aramosfet/Boards/Eaglelibs/Seeed/EagleLib-of-Seeedstudio-master/readme

The Eagle Library for most of Seeed products is open to the customer. You can update the Seeed library or submit your own library as well. It should be under the license of CC BY-SA 3.0.

2011-6-01 14:00:41

Most recently updated on 2011/10/6
