aramosfet/Boards/SniperBoardv1-1/SniperBoard BOM.txt

Partlist exported from D:/Development/Boards/SniperBoardv1-1/SniperBoard.sch at 25/11/2017 12:58:10 PM

Part  Value                     Device                    Package                   Description                                                                         MF                      MPN                            OC_FARNELL OC_NEWARK PACKAGE PROD_ID     SUPPLIER           VALUE
BAT1  3V                        BATTERY20PTH              BATTCOM_20MM_PTH          Battery Holders                                                                                                                                                                                             
C1    100uF                     CAP_POLE                  PANASONIC_E               Capacitor Polarized                                                                                                                                                                                         
C2    470uF                     CAP_POLE                  PANASONIC_E               Capacitor Polarized                                                                                                                                                                                         
C3    0.1uF                     CAP0805                   0805                      Capacitor                                                                                                                                                                                                   
C4    470uF                     CAP_POLE                  PANASONIC_E               Capacitor Polarized                                                                                                                                                                                         
C5    10uF                      10UF-TANT                 EIA3216                   10uF Tantalum SMT                                                                                                                                                       CAP-00811                      10uF 
C6    0.1uF                     CAP0805                   0805                      Capacitor                                                                                                                                                                                                   
C7    0.1uF                     CAP0805                   0805                      Capacitor                                                                                                                                                                                                   
C8    0.1uF                     CAP0805                   0805                      Capacitor                                                                                                                                                                                                   
C9    0.1uF                     CAP0805                   0805                      Capacitor                                                                                                                                                                                                   
C10   0.1uF                     CAP0805                   0805                      Capacitor                                                                                                                                                                                                   
C11   20pF                      CAP0805                   0805                      Capacitor                                                                                                                                                                                                   
C12   20pF                      CAP0805                   0805                      Capacitor                                                                                                                                                                                                   
C13   27pF                      CAP0805                   0805                      Capacitor                                                                                                                                                                                                   
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
D6    1N4148WS-V-GS18           DIODESMA-ALT              SMA-DIODE_ALT             Diode                                                                                                                                                                                                       
D7    1N4148WS-V-GS18           DIODESMA-ALT              SMA-DIODE_ALT             Diode                                                                                                                                                                                                       
D8    1N5819                    DIODESMB                  SMB-DIODE                 Diode                                                                                                                                                                                                       
DC1                             NME                       NME                       DC-DC CONVERTER                                                                     C & D TECHNOLOGIES, INC NME1205D                       1021466    98B8198                                               
FID1  FIDUCIAL1.5X3             FIDUCIAL1.5X3             FIDUCIAL-1.5X3            Fiducial Alignment Points                                                                                                                                                                                   
FID2  FIDUCIAL1.5X3             FIDUCIAL1.5X3             FIDUCIAL-1.5X3            Fiducial Alignment Points                                                                                                                                                                                   
IC1   LDL117S33                 LD117ADT12TR              DPACK                     Low drop fixed and adjustable positive voltage regulators 1 A                                                                                                                                               
IC2   LM2596S                   LM2596S                   TO263-5                   SIMPLE SWITCHER® Power Converter 150 kHz 3A Step-Down Voltage Regulator             NATIONAL SEMICONDUCTOR  LM2596S-ADJ/NOPB               9494367    41K3842                                               
IC3   LD117AS50TR               LD117AS50TR               SOT223                    Low drop fixed and adjustable positive voltage regulators 1 A                                                                                                                                               
IC5   SI7006-A10-IM             SI7006-A10-IM             DFN6-3X3                  I2C Humidity and Temperature Sensor                                                 Silicon Labs            Si7006-A10-IM                  unknown    unknown                                               
J2                              RJ45-HR911105A-HR911105A  RJMG1BD3B8K1ANR                                                                                                                                                                                                                       
J4                              RJ45-HR911105A-HR911105A  RJMG1BD3B8K1ANR                                                                                                                                                                                                                       
JP1                             M03PTH                    1X03                      Header 3                                                                                                                                                                                                    
JP2                             M03POLAR                  MOLEX-1X3                 Header 3                                                                                                                                                                                                    
JP3   USB-B                     USBPTH                    USB-B-PTH                 USB Connectors                                                                                                                                                          CONN-08278                     USB-B
JP4                             M03PTH                    1X03                      Header 3                                                                                                                                                                                                    
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
T2    MOSFET-NCHANNELBSS123LT1G MOSFET-NCHANNELBSS123LT1G SOT23                     Common NMOSFET Parts                                                                                                                                                    TRANS-08345                         
T3    MOSFET-NCHANNELBSS123LT1G MOSFET-NCHANNELBSS123LT1G SOT23                     Common NMOSFET Parts                                                                                                                                                    TRANS-08345                         
T4    MOSFET-NCHANNELBSS123LT1G MOSFET-NCHANNELBSS123LT1G SOT23                     Common NMOSFET Parts                                                                                                                                                    TRANS-08345                         
U$1   ENC424J600                ENC424J600                TQFP-44                   MICROCHIP ENC424J600                                                                                                                                                                                        
U$2   1X02_TERMB_RA             1X02_TERMB_RA             1X02_TERMB_RA                                                                                                                                                                                                                         
U$3   ENC424J600                ENC424J600                TQFP-44                   MICROCHIP ENC424J600                                                                                                                                                                                        
U$4   NC7SP157                  NC7SP157                  SC70-6                                                                                                                                                                                                                                
U$5   STM32F030K6T6             STM32F030K6T6             LQFP32-7X7                                                                                                                                                                                                                            
U1    MAX485                    MAX485                    SOP8                                                                                                                                                                                                                                  
U2    STM32F103CBT6             STM32F103CBT6             QFP50P900X900X160-48N     Medium-density performance line ARM-based 32-bit MCU                                                        STM32F103CBT6                  1606327    11N8296   QFP-48              STMICROELECTRONICS      
U3    MC34063SMD                MC34063SMD                SO08                      Jellybean switching supply controller                                                                                                                                                                       
U4    ST232CDR                  ST232CDR                  SOIC127P600X175-16N       5 V powered multi-channel RS-232 drivers and receivers                                                      ST232CDR                       1564303    89K0993   SOIC-16             STMICROELECTRONICS      
U5    S25FL004K0XMFI040         S25FL004K0XMFI040         SOIC127P600X175-8N        4-Mbit CMOS 3.0 Volt Flash Memory                                                                           S25FL004K0XMFI040              -          22T5467   SOIC-8              SPANSION                
U6    LCD-16X2SILK              LCD-16X2SILK              LCD-16X2                  Standard text-only 16x2 parallel input LCD                                                                                                                                                                  
X1                              DB9FEMALE                 DB9                       DB9 Connector                                                                                                                                                                                               
Y1    32.768Khz                 MC-306                    MC-306                    kHz RANGE CRYSTAL UNIT SMD                                                                                  MC-306 60.0KHZ  100PPM ,12.5PF 1278040    31M5576                                               
Y2    8Mhz                      CRYSTALHC49US             HC49US                    Various standard crystals. Proven footprints. Spark Fun Electronics SKU : COM-00534                                                                                                                         
Y3    25Mhz                     CRYSTAL10.5X4.8           CRYSTAL-SMD-10.5X4.8-2PIN Various standard crystals. Proven footprints. Spark Fun Electronics SKU : COM-00534                                                                                                                         
Y4    25Mhz                     CRYSTAL10.5X4.8           CRYSTAL-SMD-10.5X4.8-2PIN Various standard crystals. Proven footprints. Spark Fun Electronics SKU : COM-00534
