aramosfet/Boards/SniperBoardv1-1/SniperBoard BOM.xls

Sheet: SniperBoard
Qty | Purchase Qty | Value | Device | Source | Package | Parts | Description
1 | 8 |  | DB9FEMALE | SP Road | DB9 Femail PCB Right Angle | X1 | DB9 Connector
8 | 65 |  | M025MM | SP Road | SCREWTERMINAL-5MM-2 | JP10, JP13, JP14, JP15, JP16, JP17, JP18, JP19 | Header 2
3 | 2 |  | M02PTH | SP Road | Berg stick | JP6, JP8, JP9 | Header 2
5 | 45 |  | M03-SCREW-5MM | SP Road | SCREWTERMINAL-5MM-3 | JP20, JP21, JP22, JP23, JP24,JP4, JP7 | Header 3
2 | 15 |  | M03POLAR | SP Road | Relimate 3 pin | JP2, JP25 | Header 3
2 | 15 |  | M02POLAR | SP Road | Relimate 2 pin
1 |  |  | CRE505S | Digikey | NME | DC1 | DC-DC CONVERTER
2 |  |  | RJ45-HR911105A-HR911105A | Digikey | RJMG1BD3B8K1ANR | J2, J4
3 | 30 |  | TAC_SWITCHPTH | SP Road | TACTILE-PTH | S1, S2, S5 | Momentary Switch
2 | 100 | 0R | RESISTOR0805-RES | SP Road | 0805 | R59, R60 | Resistor
8 | 100 | 0.01uF | CAP0805 | SP Road | 0805 | C29, C30, C31, C32, C41, C42, C43, C44 | Capacitor
27 | 200 | 0.1uF | CAP0805 | SP Road | 0805 | C3, C6, C7, C8, C9, C10, C18, C19, C20, C21, C22, C23, C27, C28, C33, C34, C35, C38, C39, C45, C46, C47, C48, C49, C50, C51, C52 | Capacitor
1 |  | 0.68R | RESISTOR0805-RES | Digikey | 805 | R7 | Resistor
2 | 100 | 1.5K | RESISTOR0805-RES | SP Road | 0805 | R9, R45 | Resistor
4 | 100 | 100K | RESISTOR0805-RES | SP Road | 0805 | R11, R20, R47, R48 | Resistor
2 |  | 100uF | CAP_POLE | Digikey | PANASONIC_E | C1, C15 | Capacitor Polarized
6 | 100 | 10K | RESISTOR0805-RES | SP Road | 0805 | R4, R28, R29, R43, R56, R57 | Resistor
1 | 100 | 120R | RESISTOR1206 | SP Road | 1206 | R58 | Resistor
2 | 100 | 10R | RESISTOR0805-RES | SP Road | 0805 | R16, R25 | Resistor
2 | 40 | 10uF | 10UF-TANT | SP Road | CASE B | C5, C16,C26, C40 | 10uF Tantalum SMT
3 |  | 10uH | INDUCTOR0805 | Digikey | 805 | L2, L4, L5 | Inductors
2 |  | 12.4K | RESISTOR0805-RES | Digikey | 805 | R10, R19 | Resistor
1 |  | 13K | RESISTOR0805-RES | Digikey | 805 | R8 | Resistor
1 | 100 | 1K | RESISTOR0805-RES | SP Road | 0805 | R1 | Resistor
4 | 40 | 1N4148WS-V-GS18 | DIODESMA-ALT | SP Road | SOD | D2, D3, D6, D7 | Diode
1 | 10 | 1N5819 | DIODESMB | SP Road | SMB-DIODE | D8 | Diode
1 | 10 | 1X02_TERMB_RA | 1X02_TERMB_RA | SP Road | 1X02_TERMB_RA Pluggable | U$2
1 | 100 | 2.2K | RESISTOR0805-RES | SP Road | 0805 | R2 | Resistor
2 | 100 | 20pF | CAP0805 | SP Road | 0805 | C11, C12 | Capacitor
1 | 100 | 220pF | CAP0805 | SP Road | 0805 | C17 | Capacitor
2 |  | 220uH | INDUCTORRADIAL5MM | Digikey | RLB914-IND | L1, L3 | Inductors
2 | 100 | 22R | RESISTOR0805-RES | SP Road | 0805 | R5, R6 | Resistor
2 |  | 25Mhz | CRYSTAL10.5X4.8 | Digikey | CRYSTAL-SMD-10.5X4.8-2PIN | Y3, Y4 | Various standard crystals. Proven footprints. Spark Fun Electronics SKU : COM-00534
6 | 100 | 27pF | CAP0805 | SP Road | 0805 | C13, C14, C24, C25, C36, C37 | Capacitor
1 |  | 32.768Khz | MC-306 | Digikey | MC-306 | Y1 | kHz RANGE CRYSTAL UNIT SMD
1 | 10 | 3V | BATTERY20PTH | SP Road | CR2032 Holder+Battery | BAT1 | Battery Holders
25 | 200 | 470R | RESISTOR0805-RES | SP Road | 0805 | R3, R17, R18, R26, R27, R31, R32, R33, R34, R35, R36, R37, R38, R39, R40, R41, R42, R44, R49, R50, R51, R52, R53, R54, R55 | Resistor
2 |  | 470uF | CAP_POLE | Digikey | PANASONIC_E | C2, C4 | Capacitor Polarized
8 |  | 49.9R | RESISTOR0805-RES | Digikey | 805 | R12, R13, R14, R15, R21, R22, R23, R24 | Resistor
25 | 200 | 330R | RESISTOR0805-RES | SP Road | 0805 | R3, R17, R18, R26, R27, R31, R32, R33, R34, R35, R36, R37, R38, R39, R40, R41, R42, R44, R49, R50, R51, R52, R53, R54, R55 | Resistor
1 | 10 | 8Mhz | CRYSTALHC49US | SP Road | HC49US half size TH | Y2 | Various standard crystals. Proven footprints. Spark Fun Electronics SKU : COM-00534
1 |  | BAS40-05 | BAS40-05 | Digikey | SOT23 | D5 | Silicon Schottky Diodes
2 |  | ENC424J600 | ENC424J600 | Digikey | TQFP-44 | U$1, U$3 | MICROCHIP ENC424J600
13 | 120 | Green | LED1206 | SP Road | LED-1206 | LED1, LED2, LED3, LED4, LED5, LED6, LED7, LED8, LED9, LED10, LED11, LED12, LED13 | LEDs
1 |  | LCD-16X2SILK | LCD-16X2SILK | SP Road | LCD-16X2 | U6 | Standard text-only 16x2 parallel input LCD
1 | 10 | LD117AS50TR (AMS1117-5.0) | LD117AS50TR | SP Road | SOT223 | IC3 | Low drop fixed and adjustable positive voltage regulators 1 A
1 |  | LDL117S33 | LD117ADT12TR | Digikey | DPACK | IC1 | Low drop fixed and adjustable positive voltage regulators 1 A
1 |  | LM2596S | LM2596S | Digikey | TO263-5 | IC2 | SIMPLE SWITCHER® Power Converter 150 kHz 3A Step-Down Voltage Regulator
1 | 10 | M05X2SHD 10 pin Header | M05X2SHD | SP Road | 2X5-SHROUDED | JP12 | Header 5x2
1 | 10 | MAX485 /SP3485 Eq | MAX485 | SP Road | SOP8 | U1
1 | 10 | MC34063SMD | MC34063SMD | SP Road | SO08 | U3 | Jellybean switching supply controller
4 | 40 | 2N7002 -BSS123LT1G | MOSFET-NCHANNELBSS123LT1G | SP Road | SOT23 | T1, T2, T3, T4 | Common NMOSFET Parts
1 |  | NC7SP157 | NC7SP157 | Digikey | SC70-6 | U$4
8 | 65 | PC817 | PC817 | SP Road | DIL04 | OK1, OK2, OK3, OK4, OK5, OK6, OK7, OK8 | SHARP OPTO COUPLER
1 |  | S25FL004K0XMFI040 | S25FL004K0XMFI040 | Digikey | SOIC127P600X175-8N | U5 | 4-Mbit CMOS 3.0 Volt Flash Memory
1 |  | SI7006-A10-IM | SI7006-A10-IM | Digikey | DFN6-3X3 | IC5 | I2C Humidity and Temperature Sensor
2 | 20 | SK34 | DIODESMA | SP Road | SMA-DIODE | D1, D4 | Diode
1 | 10 | ST3232CDR | ST232CDR | SP Road | SOIC127P600X175-16N | U4 | 5 V powered multi-channel RS-232 drivers and receivers
1 |  | STM32F030K6T6 | STM32F030K6T6 | Digikey | LQFP32-7X7 | U$5
1 |  | STM32F103CBT6 | STM32F103CBT6 | Digikey | QFP50P900X900X160-48N | U2 | Medium-density performance line ARM-based 32-bit MCU
1 | 10 | TRIMPOT 10K | TRIMPOTPTH | SP Road | TRIM_POT_PTH | R30 | Various small potentiometers for set-and-forget" applications"
1 | 10 | USB-B | USBPTH | SP Road | USB-B-PTH | JP3 | USB Connectors
4 | 40 | ZF112 | ZF112 | SP Road | ZF112 | K1, K2, K3, K4 | RELAY

Sheet: Sheet1
Qty | Value | Device | Package | Price | Cost
8 |  | DB9FEMALE | DB9 Femail PCB Right Angle | 10 | 80
65 |  | M025MM | SCREWTERMINAL-5MM-2 | 3 | 195
2 |  | M02PTH | Berg stick | 10 | 20
45 |  | M03-SCREW-5MM | SCREWTERMINAL-5MM-3 | 4.5 | 202.5
15 |  | M03POLAR | Relimate 3 pin | 4 | 60
15 |  | M02POLAR | Relimate 2 pin | 6 | 90
30 |  | TAC_SWITCHPTH | TACTILE-PTH | 5 | 150
100 | 0R | RESISTOR0805-RES | 0805 | 0.2 | 20
100 | 0.01uF | CAP0805 | 0805 | 0.5 | 50
200 | 0.1uF | CAP0805 | 0805 | 0.5 | 100
100 | 1.5K | RESISTOR0805-RES | 0805 | 0.2 | 20
100 | 100K | RESISTOR0805-RES | 0805 | 0.2 | 20
100 | 10K | RESISTOR0805-RES | 0805 | 0.2 | 20
100 | 120R | RESISTOR1206 | 1206 | 0.2 | 20
100 | 10R | RESISTOR0805-RES | 0805 | 0.2 | 20
40 | 10uF | 10UF-TANT | CASE B | 6 | 240
100 | 1K | RESISTOR0805-RES | 0805 | 0.2 | 20
40 | 1N4148WS-V-GS18 | DIODESMA-ALT | SOD | 1 | 40
10 | 1N5819 | DIODESMB | SMB-DIODE | 4 | 40
10 | 1X02_TERMB_RA | 1X02_TERMB_RA | 1X02_TERMB_RA Pluggable | 10 | 100
100 | 2.2K | RESISTOR0805-RES | 0805 | 0.2 | 20
100 | 20pF | CAP0805 | 0805 | 0.5 | 50
100 | 220pF | CAP0805 | 0805 | 0.5 | 50
100 | 22R | RESISTOR0805-RES | 0805 | 0.2 | 20
100 | 27pF | CAP0805 | 0805 | 0.5 | 50
10 | 3V | BATTERY20PTH | CR2032 Holder+Battery | 15 | 150
200 | 470R | RESISTOR0805-RES | 0805 | 0.2 | 40
200 | 330R | RESISTOR0805-RES | 0805 | 0.2 | 40
10 | 8Mhz | CRYSTALHC49US | HC49US half size TH | 8 | 80
140 | Green | LED1206 | LED-1206 | 2 | 280
 | LCD-16X2SILK | LCD-16X2SILK | LCD-16X2 |  | 0
10 | LD117AS50TR (AMS1117-5.0) | LD117AS50TR | SOT223 | 8 | 80
10 | M05X2SHD 10 pin Header | M05X2SHD | 2X5-SHROUDED | 5 | 50
10 | MAX485 /SP3485 Eq | MAX485 | SOP8 | 110 | 1100
10 | MC34063SMD | MC34063SMD | SO08 | 10 | 100
40 | 2N7002 -BSS123LT1G | MOSFET-NCHANNELBSS123LT1G | SOT23 | 6 | 240
65 | PC817 | PC817 | DIL04 | 10 | 650
20 | SK34 | DIODESMA | SMA-DIODE | 10 | 200
6 | ST3232CDR | ST232CDR | SOIC127P600X175-16N | 25 | 150
10 | TRIMPOT 10K | TRIMPOTPTH | TRIM_POT_PTH | 2 | 20
10 | USB-B | USBPTH | USB-B-PTH | 12 | 120
24 | ZF112 | ZF112 | ZF112 | 30 | 720
1 | Kapton tape |  |  | 250 | 250
 |  |  |  |  | 5967.5
