aramosfet/Boards/SniperBoard/SniperBoard Schematics.pdf

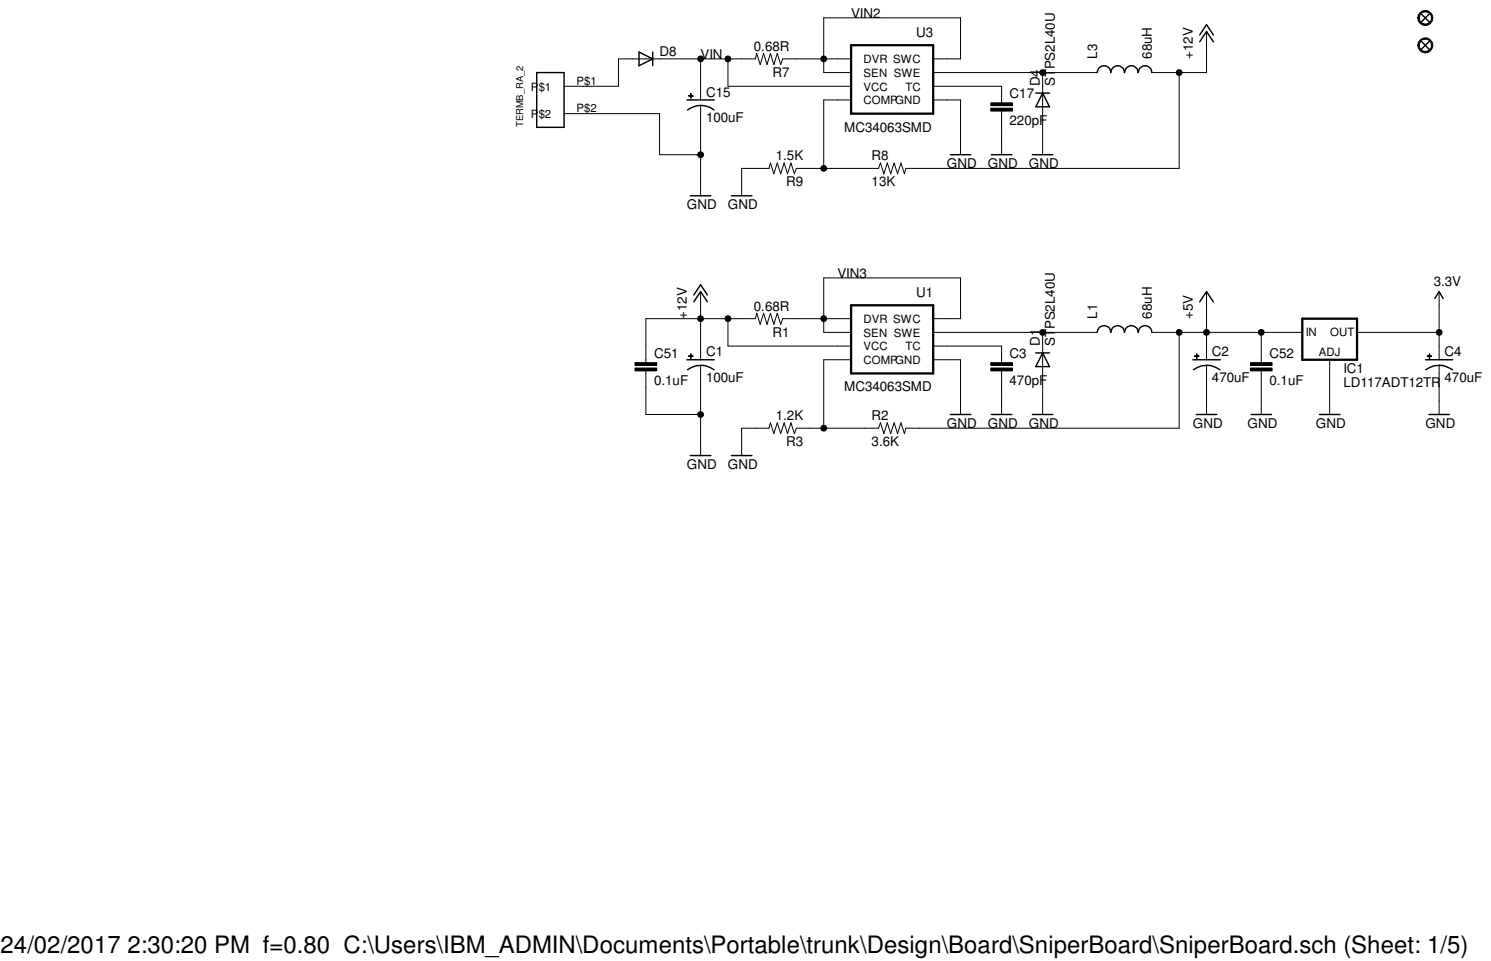
[picture p1: page 1]

24/02/2017 2:30:20 PM f=0.80 C:\Users\IBM_ADMIN\Documents\Portable\trunk\Design\Board\SniperBoard\SniperBoard.sch (Sheet: 1/5)

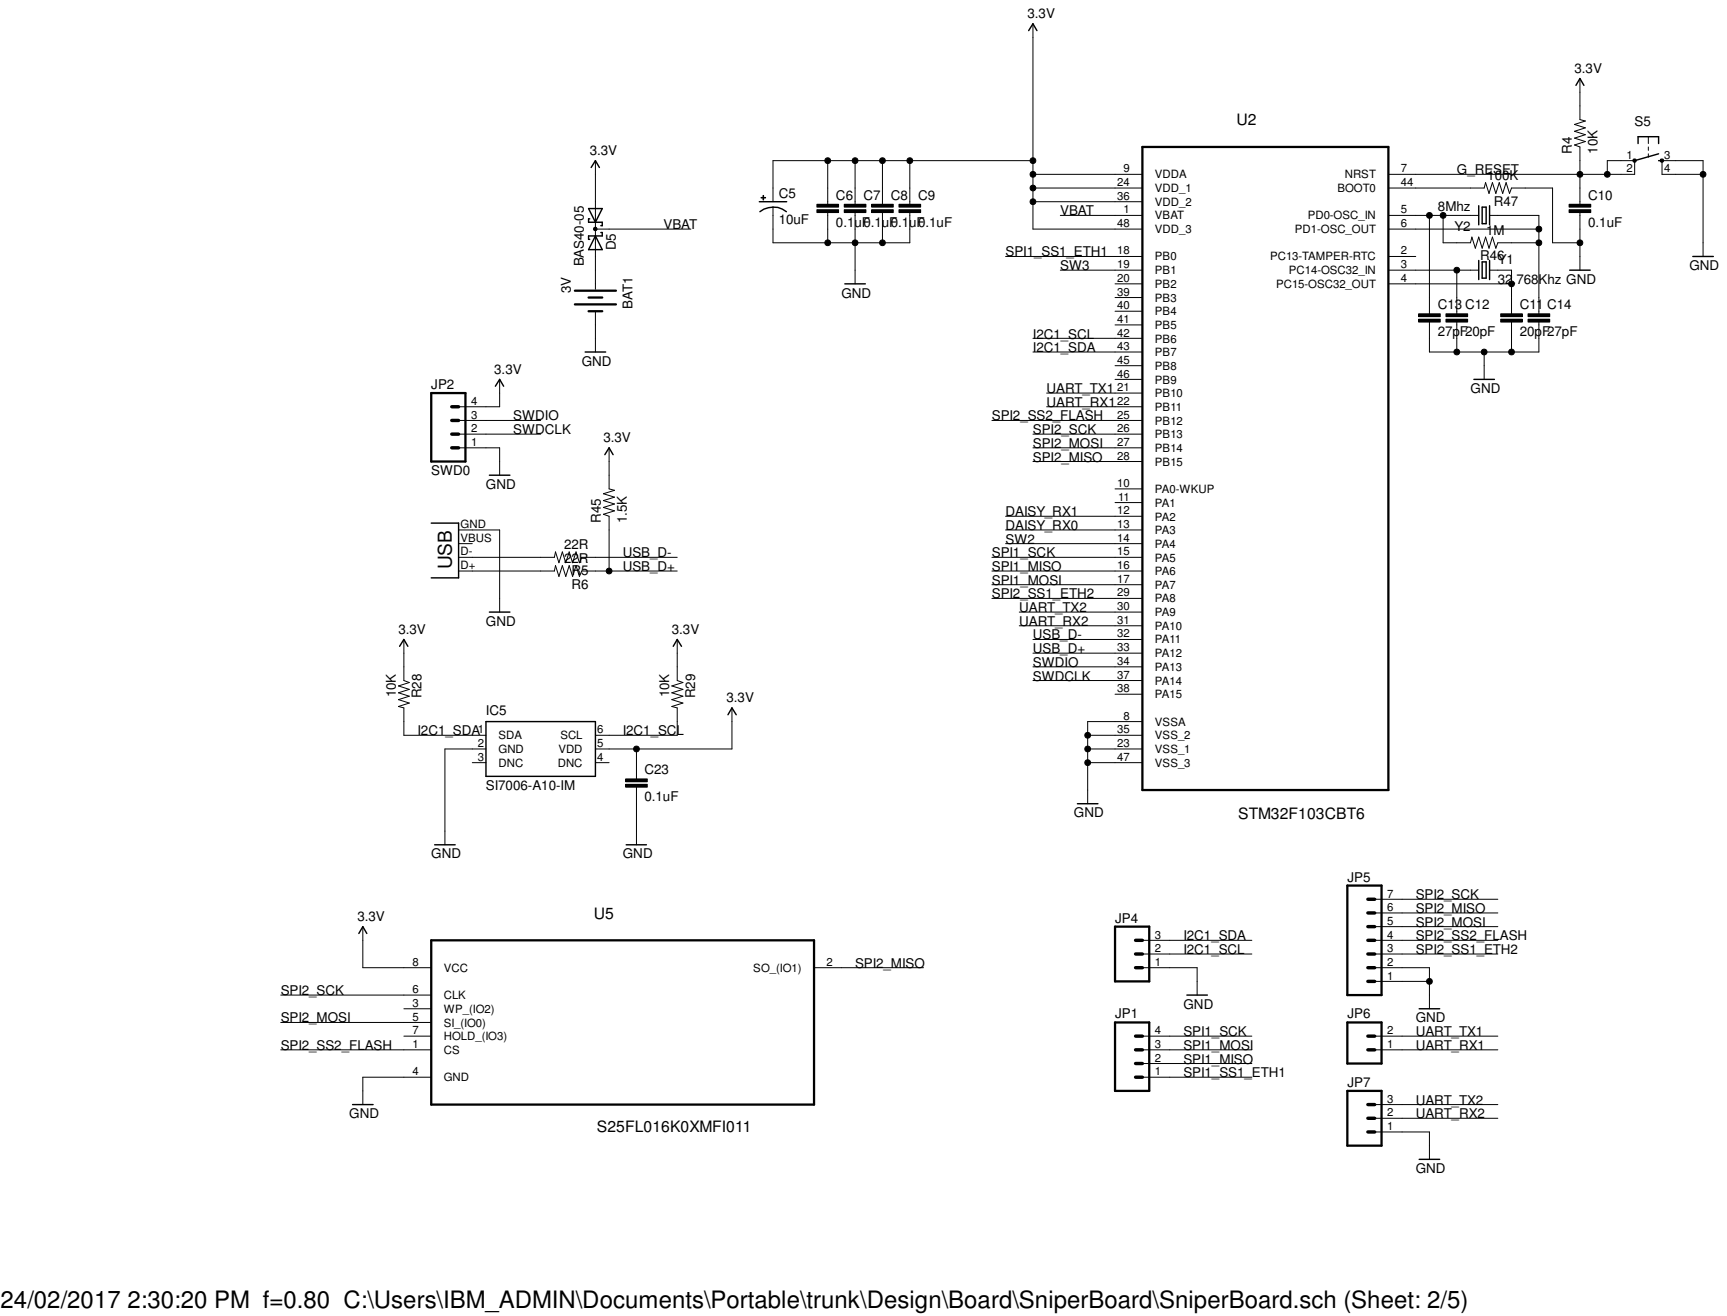
[picture p2: page 2]

24/02/2017 2:30:20 PM f=0.80 C:\Users\IBM_ADMIN\Documents\Portable\trunk\Design\Board\SniperBoard\SniperBoard.sch (Sheet: 2/5)

# GND TRIMPOT 10K

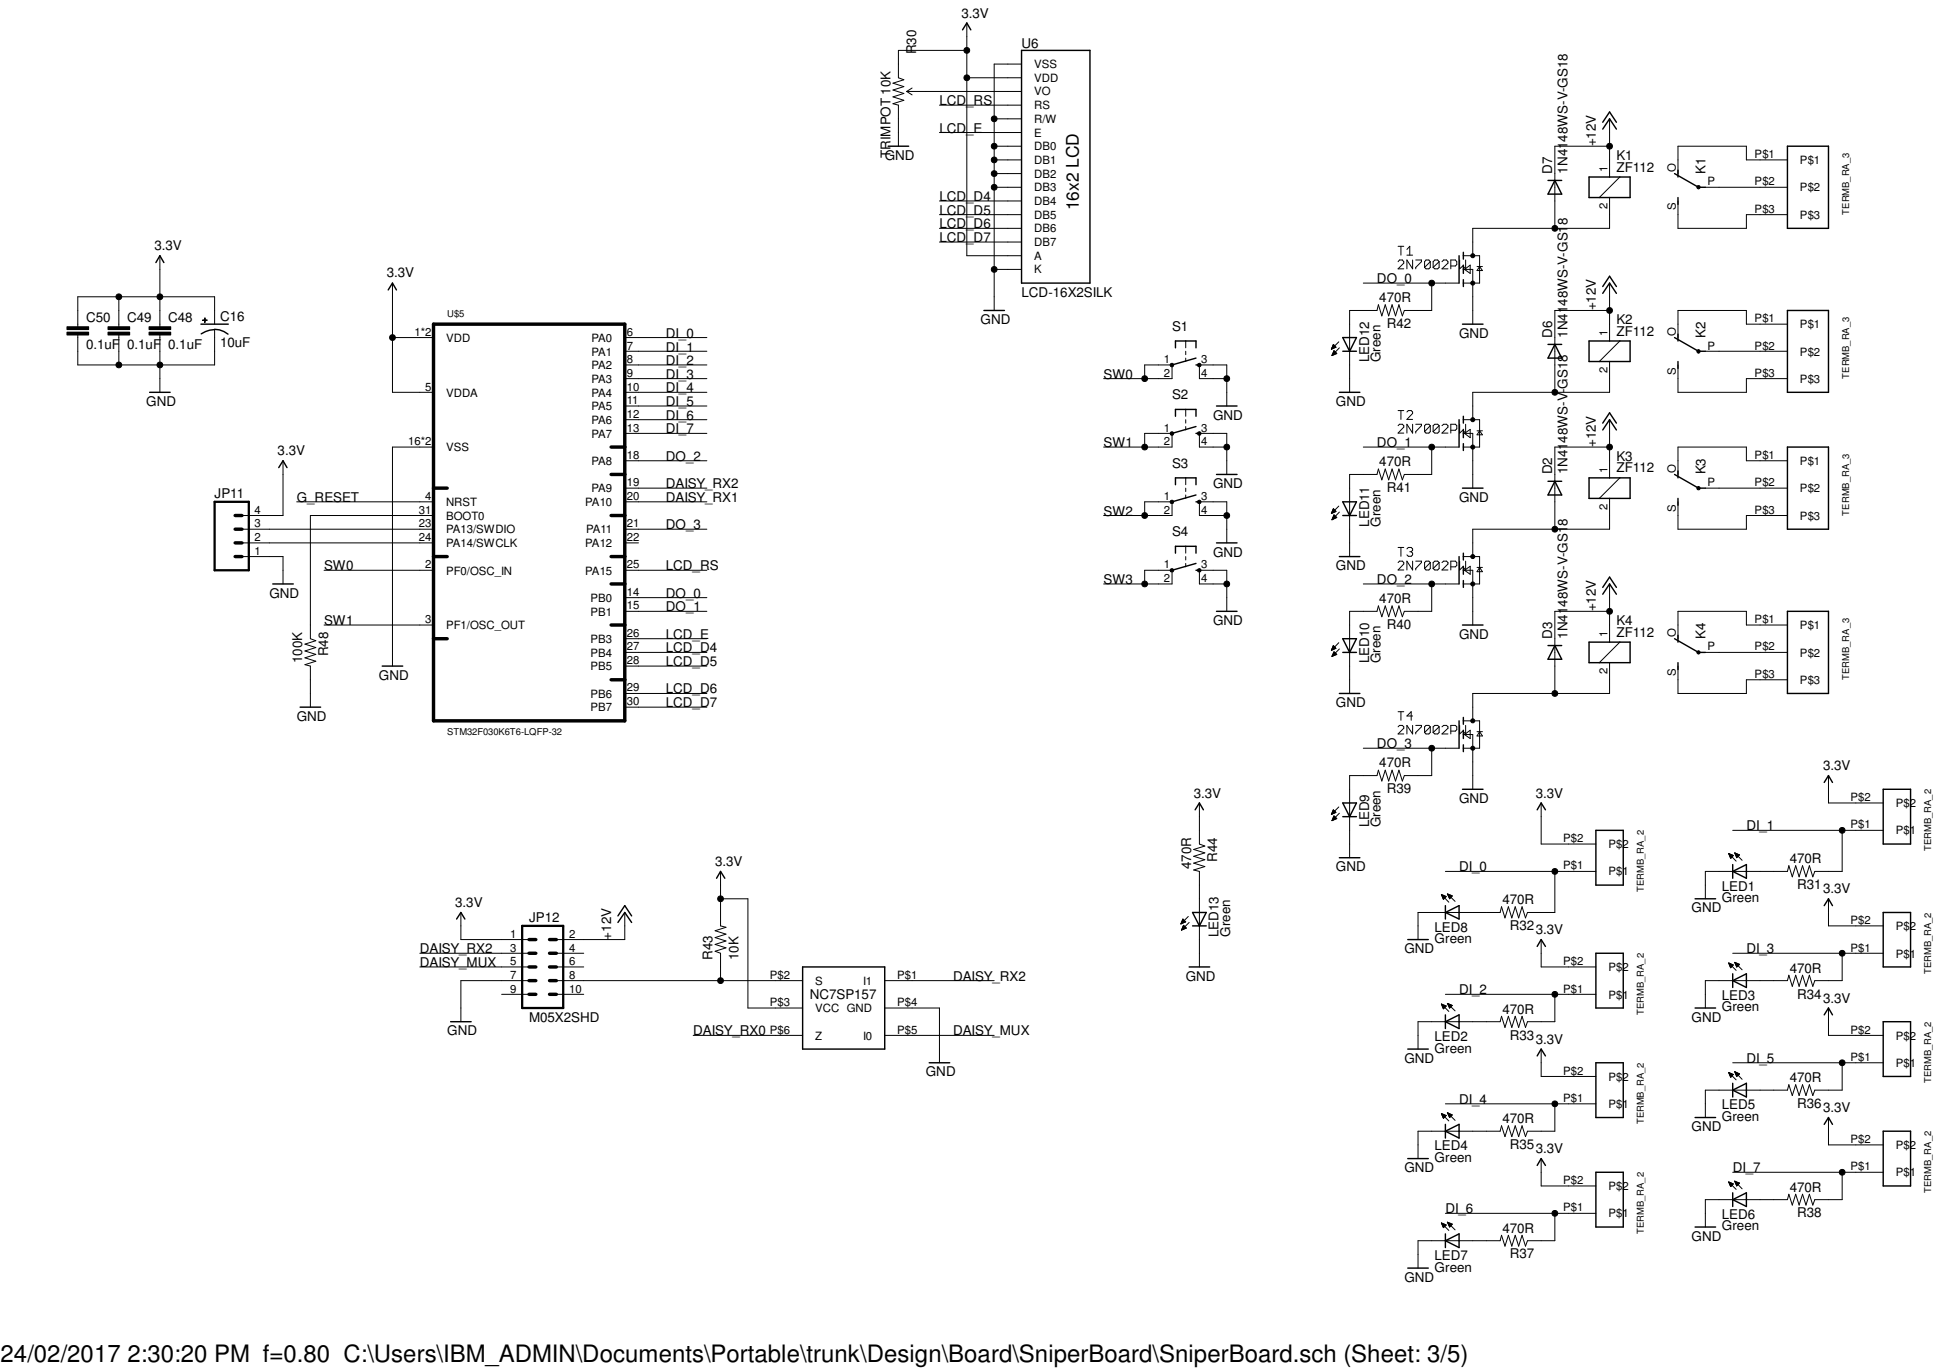
[picture p3: page 3]

24/02/2017 2:30:20 PM f=0.80 C:\Users\IBM_ADMIN\Documents\Portable\trunk\Design\Board\SniperBoard\SniperBoard.sch (Sheet: 3/5)

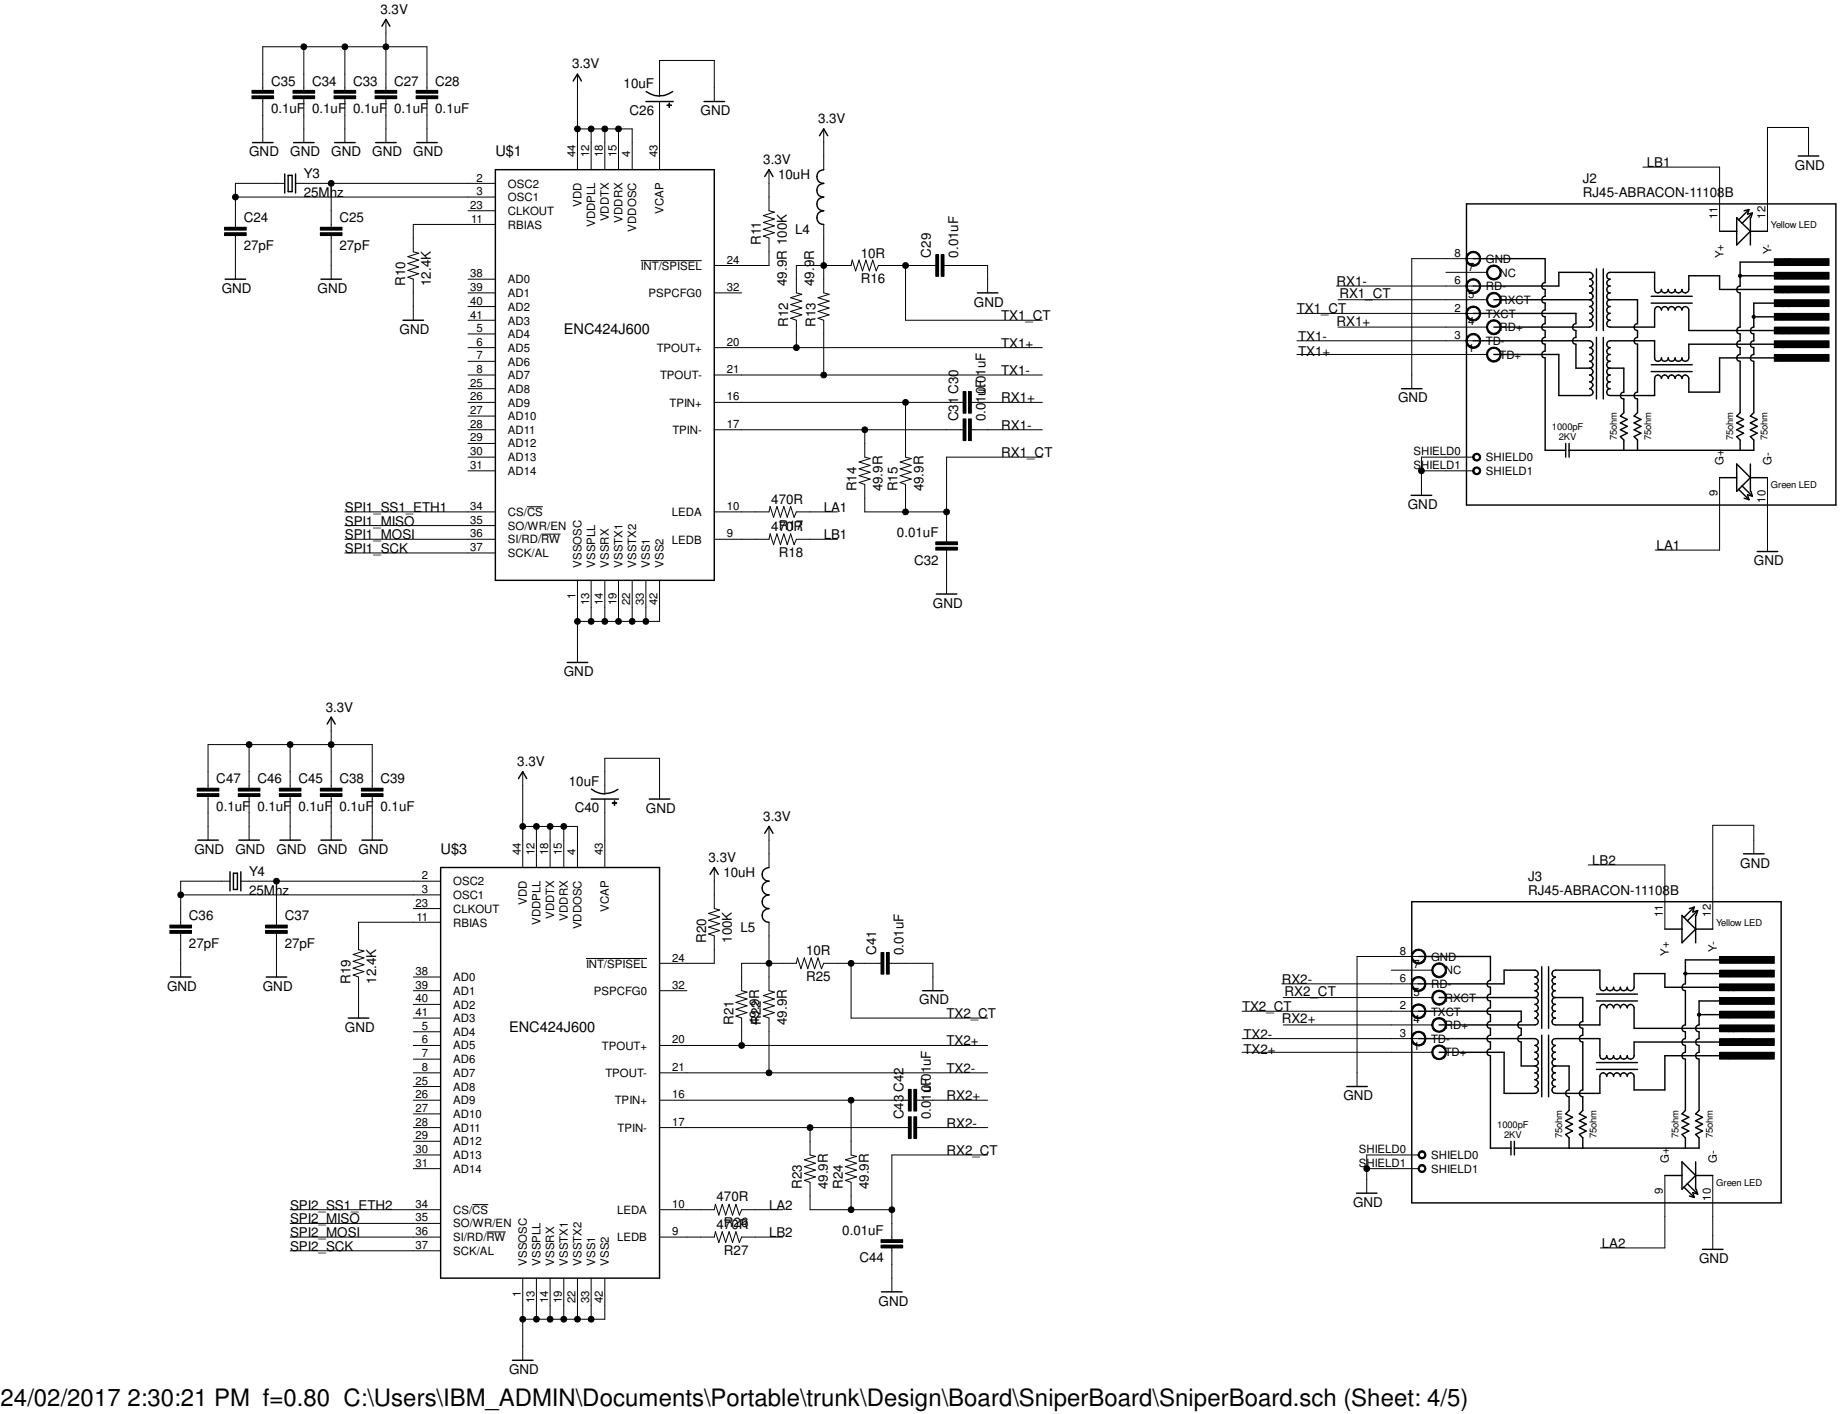
[picture p4: page 4]

CLKOUT 23 RBIAS 11

GND 8

RD- 6 TXCT 2 TD+ 1 TD- 3 SHIELD0 SHIELD0 SHIELD1 SHIELD1

24/02/2017 2:30:21 PM f=0.80 C:\Users\IBM_ADMIN\Documents\Portable\trunk\Design\Board\SniperBoard\SniperBoard.sch (Sheet: 4/5)

24/02/2017 2:30:21 PM f=0.80 C:\Users\IBM_ADMIN\Documents\Portable\trunk\Design\Board\SniperBoard\SniperBoard.sch (Sheet: 5/5)

### ST232CDR

0.1uF 0.1uF0.1uF 0.1uF 0.1uF

GND | GND | GND

GND

GND

X1

1
2 | 6
3 | 7
4 | 8
5 | 9

VCC 16

V+ 2
V- 6

C1- 3
C1+ 1
C2- 5
C2+ 4

T1IN 11
T2IN 10
R1IN 13
R2IN 8

GND 15

R1OUT | 12
T1OUT | 14
T2OUT | 7
R2OUT | 9

U4

C18 C19 C22 C21 C20

UART_RX2
232_TX 232_TX

UART_TX2

232_RX

232_RX
