aramosfet/Boards/SniperBoard/bottomlayer.pdf

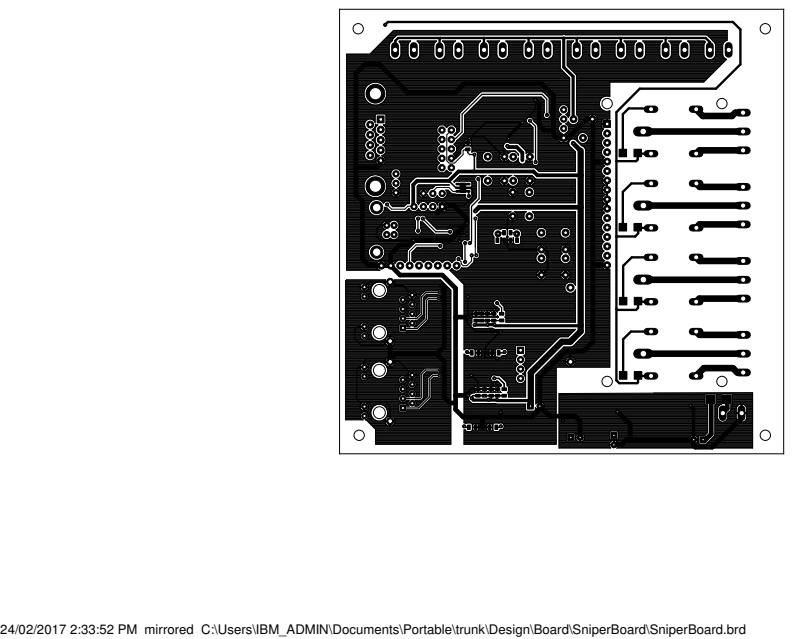
[picture p5: page 1]

24/02/2017 2:33:52 PM mirrored C:\Users\IBM_ADMIN\Documents\Portable\trunk\Design\Board\SniperBoard\SniperBoard.brd
