aramosfet/Boards/SniperBoard/SniperBoard-Bottom.pdf

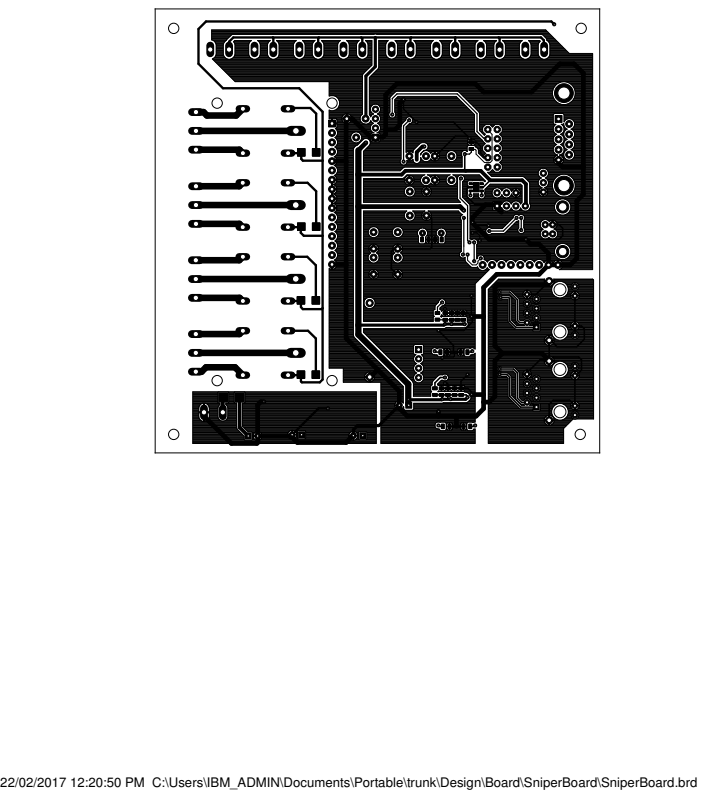
[picture p6: page 1]

22/02/2017 12:20:50 PM C:\Users\IBM_ADMIN\Documents\Portable\trunk\Design\Board\SniperBoard\SniperBoard.brd
