aramosfet/Boards/SniperBoard/SniperBoard-Top.pdf

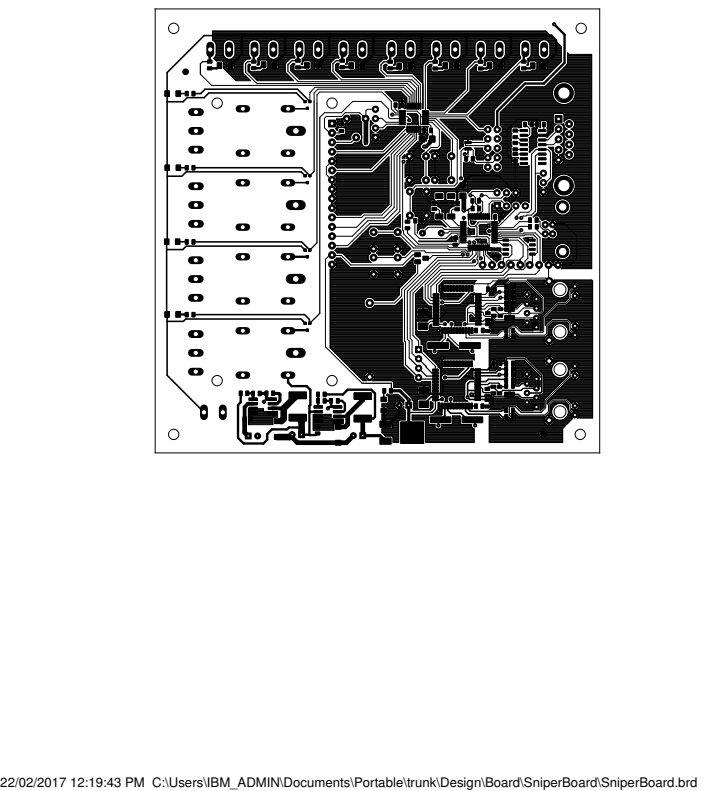
[picture p7: page 1]

22/02/2017 12:19:43 PM C:\Users\IBM_ADMIN\Documents\Portable\trunk\Design\Board\SniperBoard\SniperBoard.brd
