aramosfet/Boards/SniperBoard/Toplayer.pdf

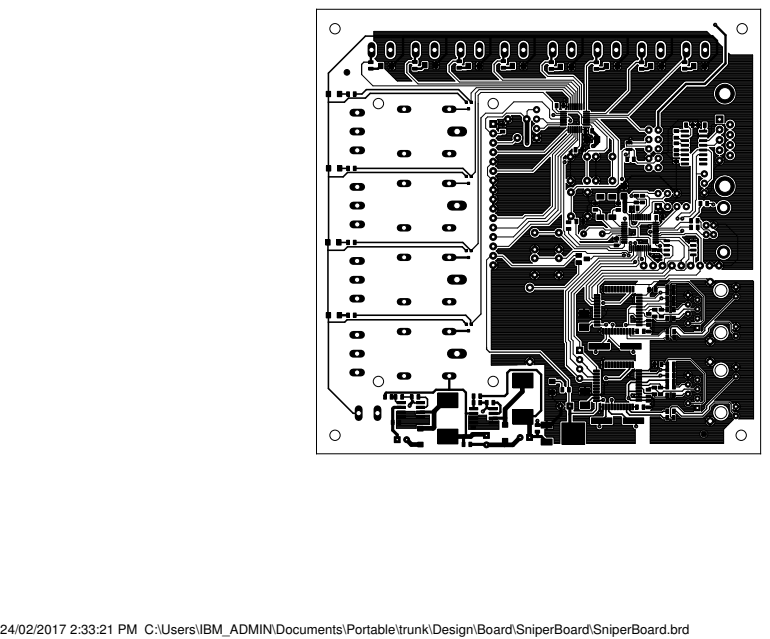
[picture p8: page 1]

24/02/2017 2:33:21 PM C:\Users\IBM_ADMIN\Documents\Portable\trunk\Design\Board\SniperBoard\SniperBoard.brd
