aramosfet/Boards/SniperBoardv1-1/SniperBoard.brd

## EAGLE design SniperBoardv1-1/SniperBoard.brd (2017-11-26)

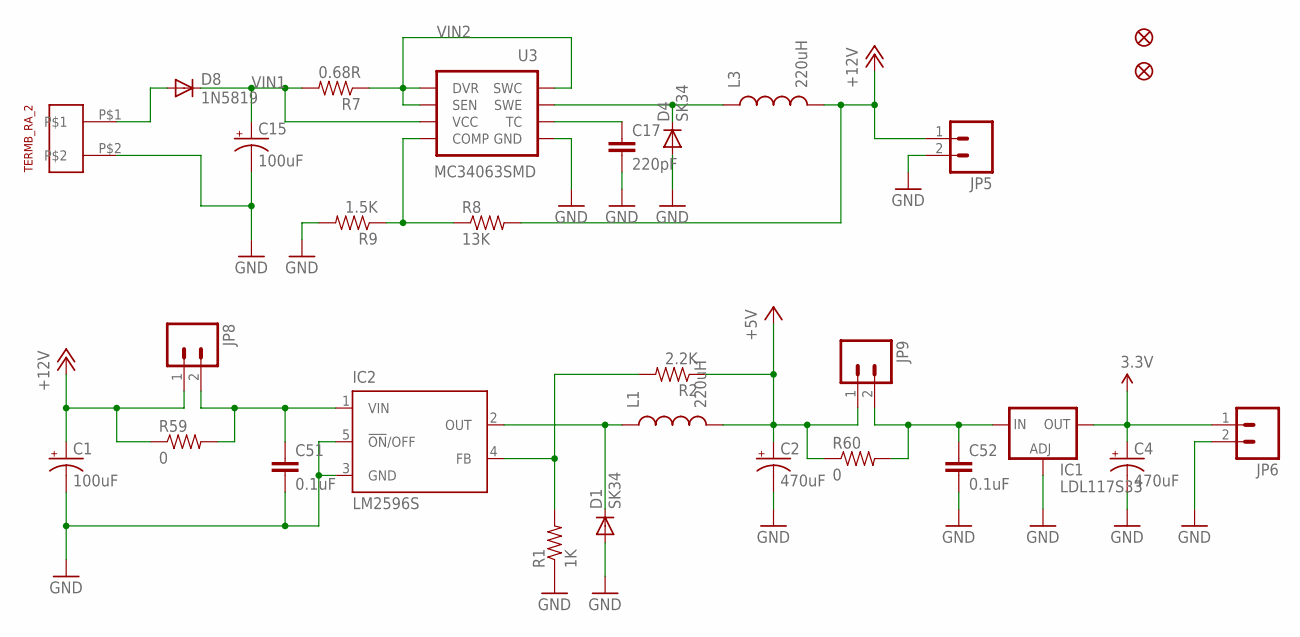
[picture p9: schematic SniperBoard.sch, sheet 1]

Parts:
C1, C15: 100uF; PANASONIC_E
C2, C4: 470uF; PANASONIC_E
C17: 220pF; 0805
C51, C52: 0.1uF; 0805
D1, D4: SK34; SMA-DIODE
D8: 1N5819; SMB-DIODE
FID1, FID2: FIDUCIAL1.5X3; FIDUCIAL-1.5X3
IC1: LDL117S33; DPACK
IC2: LM2596S; TO263-5
JP5, JP6: M02POLAR; MOLEX-1X2
JP8, JP9: M02PTH; 1X02
L1, L3: 220uH; RLB914-IND
R1: 1K; 0805
R2: 2.2K; 0805
R7: 0.68R; 0805
R8: 13K; 0805
R9: 1.5K; 0805
R59, R60: 0; 0805
U3: MC34063SMD; SO08
U$2: 1X02_TERMB_RA

Connections:
3.3V: C4.+, IC1.4 (OUT), JP6.1; also elsewhere on the board
+5V: C2.+, JP9.1, L1.P$2 (2), R2.1, R60.1
+12V: C1.+, JP5.1, JP8.1, L3.P$2 (2), R8.2, R59.1; also elsewhere on the board
GND: C1.-, C2.-, C4.-, C15.-, C17.2, C51.2, C52.2, D1.A, D4.A, IC1.1 (ADJ), IC2.3 (GND), IC2.5 (!ON!/OFF), JP5.2, JP6.2, R1.1, R9.2, U3.4 (GND), U$2.P$2; also elsewhere on the board
unnamed: IC2.4 (FB), R1.2, R2.2
unnamed: D1.C, IC2.2 (OUT), L1.P$1 (1)
unnamed: C17.1, U3.3 (TC)
unnamed: D4.C, L3.P$1 (1), U3.2 (SWE)
unnamed: R8.1, R9.1, U3.5 (COMP)
unnamed: D8.A, U$2.P$1
unnamed: C52.1, IC1.3 (IN), JP9.2, R60.2
unnamed: C51.1, IC2.1 (VIN), JP8.2, R59.2
VIN1: C15.+, D8.C, R7.2, U3.6 (VCC)
VIN2: R7.1, U3.1 (SWC), U3.7 (SEN), U3.8 (DVR)

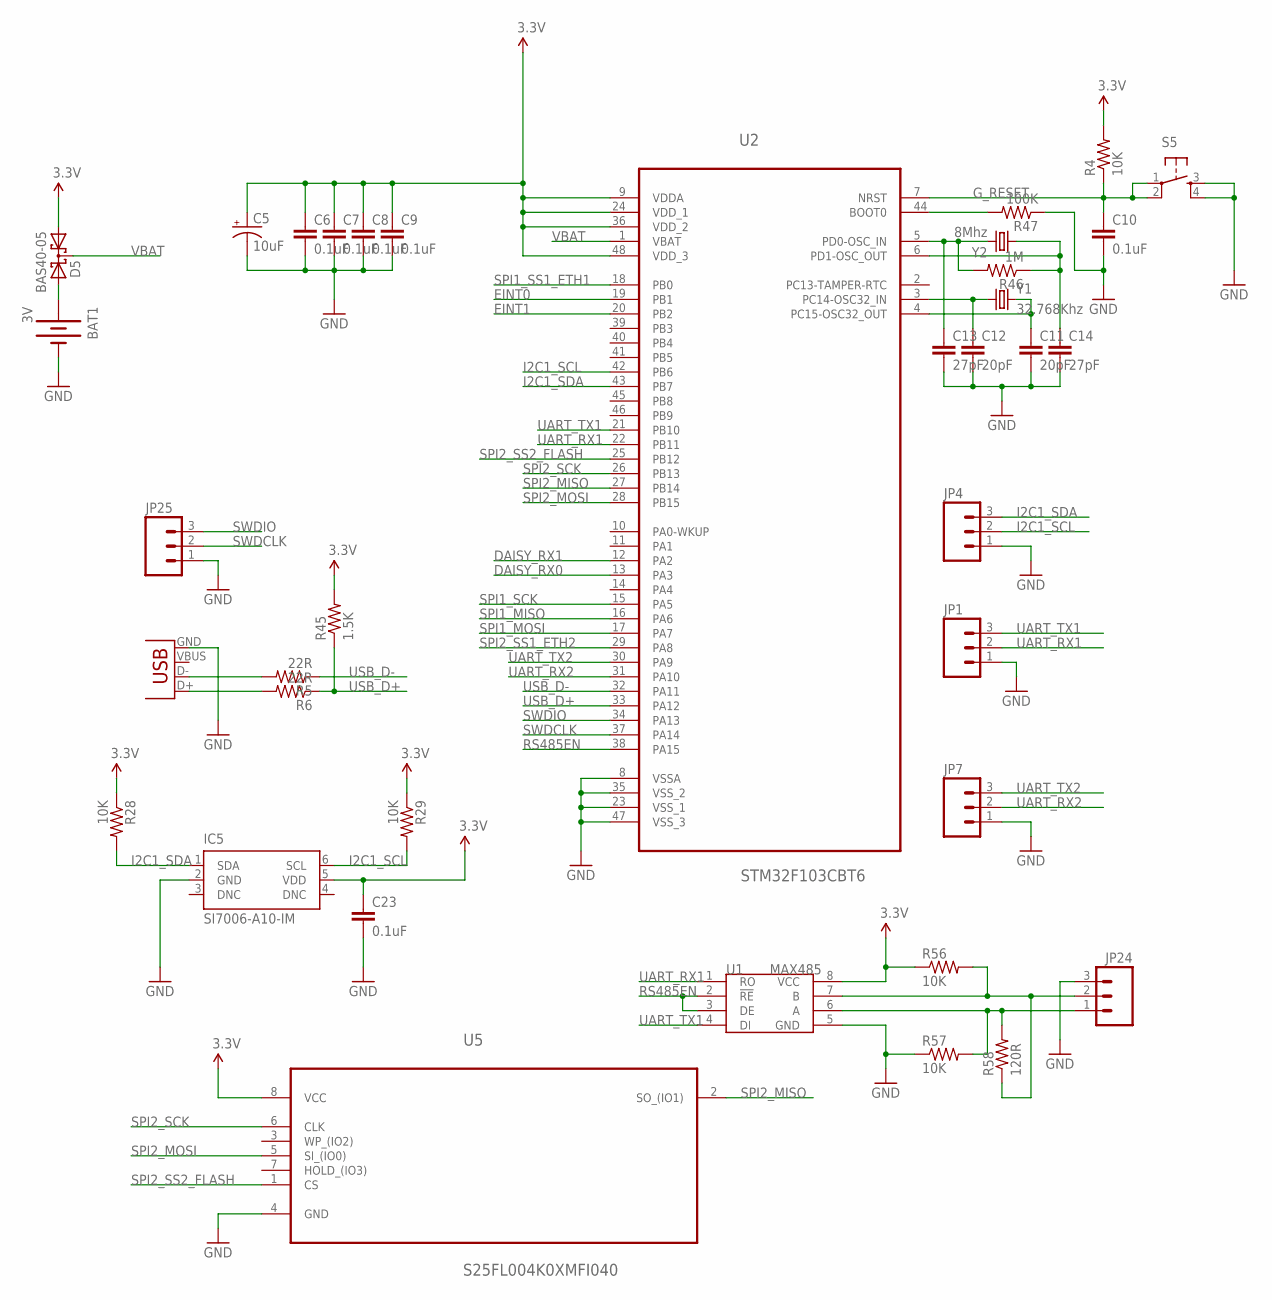
[picture p10: schematic SniperBoard.sch, sheet 2]

Parts:
BAT1: 3V; BATTCOM_20MM_PTH
C5: 10uF; EIA3216
C6, C7, C8, C9, C10, C23: 0.1uF; 0805
C11, C12: 20pF; 0805
C13, C14: 27pF; 0805
D5: BAS40-05; SOT23
IC5: SI7006-A10-IM; DFN6-3X3
JP1, JP4, JP7: M03PTH; 1X03
JP3: USB-B; USB-B-PTH
JP24: M03-SCREW-5MM; SCREWTERMINAL-5MM-3
JP25: M03POLAR; MOLEX-1X3
R4, R28, R29, R56, R57: 10K; 0805
R5, R6: 22R; 0805
R45: 1.5K; 0805
R46: 1M; 0805
R47: 100K; 0805
R58: 120R; 1206
S5: TAC_SWITCHPTH; TACTILE-PTH
U1: MAX485; SOP8
U2: STM32F103CBT6; QFP50P900X900X160-48N
U5: S25FL004K0XMFI040; SOIC127P600X175-8N
Y1: 32.768Khz; MC-306
Y2: 8Mhz; HC49US

Connections:
3.3V: C5.A (+), C6.1, C7.1, C8.1, C9.1, C23.1, D5.1 (A1), IC5.5 (VDD), R4.2, R28.1, R29.1, R45.2, R56.1, U1.8 (VCC), U2.9 (VDDA), U2.24 (VDD_1), U2.36 (VDD_2), U2.48 (VDD_3), U5.8 (VCC); also elsewhere on the board
BOOT0: R47.2, U2.44 (BOOT0)
DAISY_RX0: U2.13 (PA3); also elsewhere on the board
DAISY_RX1: U2.12 (PA2); also elsewhere on the board
EINT0: U2.19 (PB1); also elsewhere on the board
EINT1: U2.20 (PB2); also elsewhere on the board
GND: BAT1.2 (-), C5.C (-), C6.2, C7.2, C8.2, C9.2, C10.2, C11.2, C12.2, C13.2, C14.2, C23.2, IC5.2 (GND), JP1.1, JP3.GND, JP4.1, JP7.1, JP24.3, JP25.1, R47.1, R57.1, S5.3, S5.4, U1.5 (GND), U2.8 (VSSA), U2.23 (VSS_1), U2.35 (VSS_2), U2.47 (VSS_3), U5.4 (GND); also elsewhere on the board
G_RESET: C10.1, R4.1, S5.1, S5.2, U2.7 (NRST); also elsewhere on the board
I2C1_SCL: IC5.6 (SCL), JP4.2, R29.2, U2.42 (PB6)
I2C1_SDA: IC5.1 (SDA), JP4.3, R28.2, U2.43 (PB7)
unnamed: BAT1.1 (+), D5.2 (A2)
unnamed: JP24.1, R57.2, R58.2, U1.6 (A)
unnamed: C14.1, R46.1, U2.6 (PD1-OSC_OUT), Y2.1
unnamed: JP3.D-, R5.2
unnamed: JP3.D+, R6.2
unnamed: C12.1, U2.3 (PC14-OSC32_IN), Y1.1
unnamed: C11.1, U2.4 (PC15-OSC32_OUT), Y1.4 (2)
unnamed: C13.1, R46.2, U2.5 (PD0-OSC_IN), Y2.2
unnamed: JP24.2, R56.2, R58.1, U1.7 (B)
RS485EN: U1.2 (!RE), U1.3 (DE), U2.38 (PA15)
SPI1_MISO: U2.16 (PA6); also elsewhere on the board
SPI1_MOSI: U2.17 (PA7); also elsewhere on the board
SPI1_SCK: U2.15 (PA5); also elsewhere on the board
SPI1_SS1_ETH1: U2.18 (PB0); also elsewhere on the board
SPI2_MISO: U2.27 (PB14), U5.2 (SO_(IO1)); also elsewhere on the board
SPI2_MOSI: U2.28 (PB15), U5.5 (SI_(IO0)); also elsewhere on the board
SPI2_SCK: U2.26 (PB13), U5.6 (CLK); also elsewhere on the board
SPI2_SS1_ETH2: U2.29 (PA8); also elsewhere on the board
SPI2_SS2_FLASH: U2.25 (PB12), U5.1 (CS)
SWDCLK: JP25.2, U2.37 (PA14)
SWDIO: JP25.3, U2.34 (PA13)
UART_RX1: JP1.2, U1.1 (RO), U2.22 (PB11)
UART_RX2: JP7.2, U2.31 (PA10); also elsewhere on the board
UART_TX1: JP1.3, U1.4 (DI), U2.21 (PB10)
UART_TX2: JP7.3, U2.30 (PA9); also elsewhere on the board
USB_D+: R6.1, R45.1, U2.33 (PA12)
USB_D-: R5.1, U2.32 (PA11)
VBAT: D5.3 (C), U2.1 (VBAT)

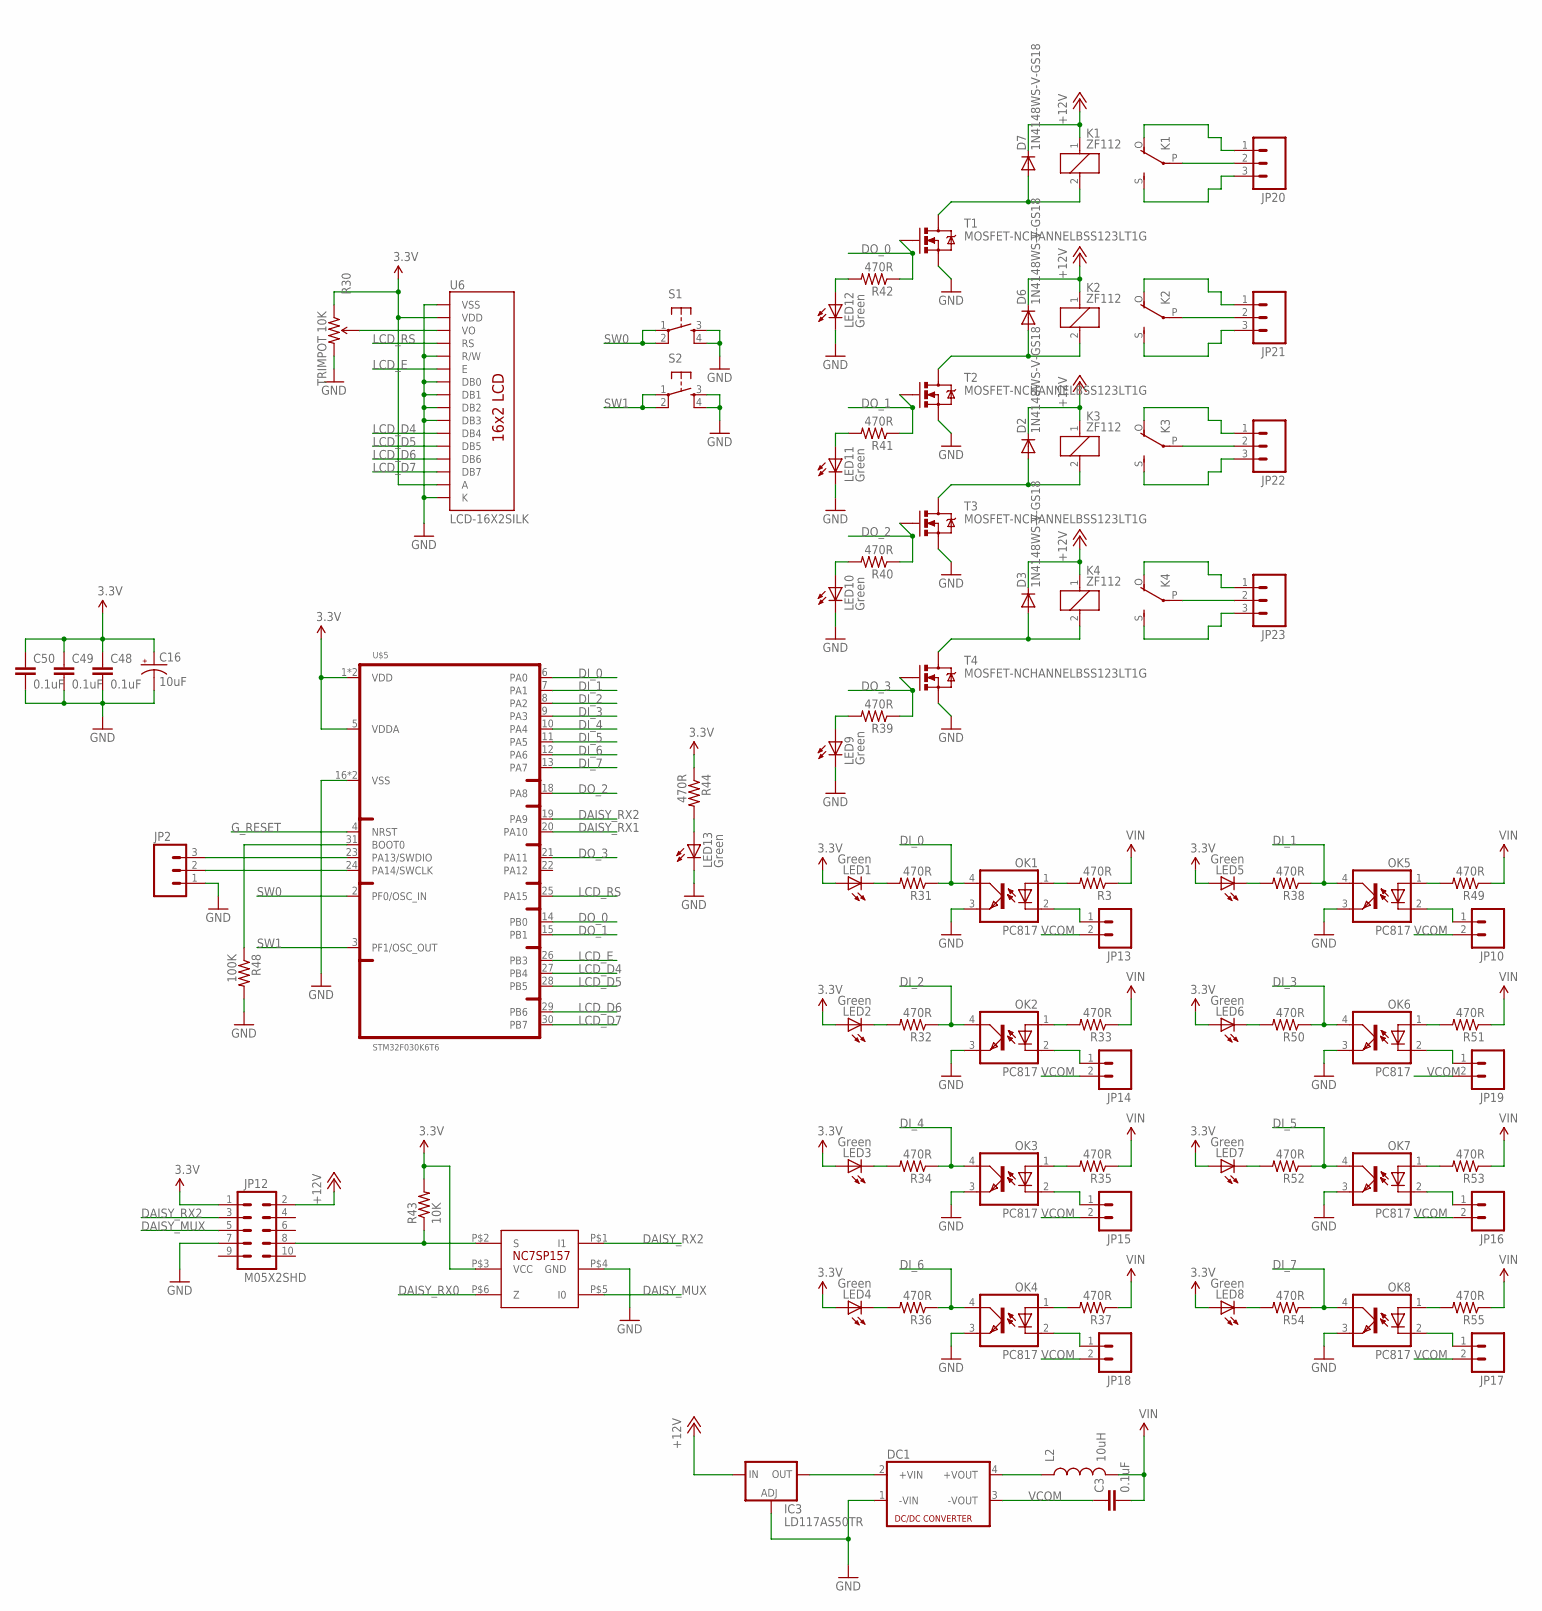
[picture p11: schematic SniperBoard.sch, sheet 3]

Parts:
C3, C48, C49, C50: 0.1uF; 0805
C16: 10uF; EIA3216
D2, D3, D6, D7: 1N4148WS-V-GS18; SMA-DIODE_ALT
DC1: NME
IC3: LD117AS50TR; SOT223
JP2: M03POLAR; MOLEX-1X3
JP10, JP13, JP14, JP15, JP16, JP17, JP18, JP19: M025MM; SCREWTERMINAL-5MM-2
JP12: M05X2SHD; 2X5-SHROUDED
JP20, JP21, JP22, JP23: M03-SCREW-5MM; SCREWTERMINAL-5MM-3
K1, K2, K3, K4: ZF112
L2: 10uH; 0805
LED1, LED2, LED3, LED4, LED5, LED6, LED7, LED8, LED9, LED10, LED11, LED12, LED13: Green; LED-1206
OK1, OK2, OK3, OK4, OK5, OK6, OK7, OK8: PC817; DIL04
R3, R31, R32, R33, R34, R35, R36, R37, R38, R39, R40, R41, R42, R44, R49, R50, R51, R52, R53, R54, R55: 470R; 0805
R30: TRIMPOT 10K; TRIM_POT_PTH
R43: 10K; 0805
R48: 100K; 0805
S1, S2: TAC_SWITCHPTH; TACTILE-PTH
T1, T2, T3, T4: MOSFET-NCHANNELBSS123LT1G; SOT23
U6: LCD-16X2SILK; LCD-16X2
U$4: NC7SP157; SC70-6
U$5: STM32F030K6T6; LQFP32-7X7

Connections:
3.3V: C16.A (+), C48.1, C49.1, C50.1, JP12.1, LED1.A, LED2.A, LED3.A, LED4.A, LED5.A, LED6.A, LED7.A, LED8.A, R30.1 (CCW), R43.2, R44.1, U6.2 (VDD), U6.15 (A), U$4.P$3 (VCC), U$5.1 (VDD), U$5.5 (VDDA), U$5.17 (VDD); also elsewhere on the board
+12V: D2.C, D3.C, D6.C, D7.C, IC3.3 (IN), JP12.2, K1.1, K2.1, K3.1, K4.1; also elsewhere on the board
DAISY_MUX: JP12.5, U$4.P$5 (I0)
DAISY_RX0: U$4.P$6 (Z); also elsewhere on the board
DAISY_RX1: U$5.20 (PA10); also elsewhere on the board
DAISY_RX2: JP12.3, U$4.P$1 (I1), U$5.19 (PA9)
DI_0: OK1.4 (COL), R31.1, U$5.6 (PA0)
DI_1: OK5.4 (COL), R38.1, U$5.7 (PA1)
DI_2: OK2.4 (COL), R32.1, U$5.8 (PA2)
DI_3: OK6.4 (COL), R50.1, U$5.9 (PA3)
DI_4: OK3.4 (COL), R34.1, U$5.10 (PA4)
DI_5: OK7.4 (COL), R52.1, U$5.11 (PA5)
DI_6: OK4.4 (COL), R36.1, U$5.12 (PA6)
DI_7: OK8.4 (COL), R54.1, U$5.13 (PA7)
DO_0: R42.1, T1.1 (G), U$5.14 (PB0)
DO_1: R41.1, T2.1 (G), U$5.15 (PB1)
DO_2: R40.1, T3.1 (G), U$5.18 (PA8)
DO_3: R39.1, T4.1 (G), U$5.21 (PA11)
GND: C16.C (-), C48.2, C49.2, C50.2, DC1.1 (-VIN), IC3.1 (ADJ), JP2.1, JP12.7, LED9.C, LED10.C, LED11.C, LED12.C, LED13.C, OK1.3 (EMIT), OK2.3 (EMIT), OK3.3 (EMIT), OK4.3 (EMIT), OK5.3 (EMIT), OK6.3 (EMIT), OK7.3 (EMIT), OK8.3 (EMIT), R30.3 (CW), R48.2, S1.3, S1.4, S2.3, S2.4, T1.2 (S), T2.2 (S), T3.2 (S), T4.2 (S), U6.1 (VSS), U6.5 (R/W), U6.7 (DB0), U6.8 (DB1), U6.9 (DB2), U6.10 (DB3), U6.16 (K), U$4.P$4 (GND), U$5.16 (VSS), U$5.32 (VSS); also elsewhere on the board
G_RESET: U$5.4 (NRST); also elsewhere on the board
LCD_D4: U6.11 (DB4), U$5.27 (PB4)
LCD_D5: U6.12 (DB5), U$5.28 (PB5)
LCD_D6: U6.13 (DB6), U$5.29 (PB6)
LCD_D7: U6.14 (DB7), U$5.30 (PB7)
LCD_E: U6.6 (E), U$5.26 (PB3)
LCD_RS: U6.4 (RS), U$5.25 (PA15)
unnamed: JP20.2, K1.P
unnamed: LED1.C, R31.2
unnamed: LED13.A, R44.2
unnamed: OK2.1 (A), R33.2
unnamed: R30.2 (WIPER), U6.3 (VO)
unnamed: JP23.1, K4.O
unnamed: R48.1, U$5.31 (BOOT0)
unnamed: OK1.1 (A), R3.2
unnamed: JP13.1, OK1.2 (C)
unnamed: JP14.1, OK2.2 (C)
unnamed: JP23.3, K4.S
unnamed: LED2.C, R32.2
unnamed: DC1.4 (+VOUT), L2.1
unnamed: DC1.2 (+VIN), IC3.4 (OUT)
unnamed: JP22.3, K3.S
unnamed: JP21.2, K2.P
unnamed: JP22.1, K3.O
unnamed: JP21.1, K2.O
unnamed: JP21.3, K2.S
unnamed: JP22.2, K3.P
unnamed: JP20.1, K1.O
unnamed: JP23.2, K4.P
unnamed: JP20.3, K1.S
unnamed: D7.A, K1.2, T1.3 (D)
unnamed: D6.A, K2.2, T2.3 (D)
unnamed: D2.A, K3.2, T3.3 (D)
unnamed: D3.A, K4.2, T4.3 (D)
unnamed: LED12.A, R42.2
unnamed: LED11.A, R41.2
unnamed: JP2.3, U$5.23 (PA13/SWDIO)
unnamed: LED10.A, R40.2
unnamed: JP2.2, U$5.24 (PA14/SWCLK)
unnamed: LED9.A, R39.2
unnamed: OK3.1 (A), R35.2
unnamed: JP15.1, OK3.2 (C)
unnamed: LED3.C, R34.2
unnamed: JP12.8, R43.1, U$4.P$2 (S)
unnamed: OK4.1 (A), R37.2
unnamed: JP18.1, OK4.2 (C)
unnamed: LED4.C, R36.2
unnamed: OK5.1 (A), R49.2
unnamed: JP10.1, OK5.2 (C)
unnamed: LED5.C, R38.2
unnamed: OK6.1 (A), R51.2
unnamed: JP19.1, OK6.2 (C)
unnamed: LED6.C, R50.2
unnamed: OK7.1 (A), R53.2
unnamed: JP16.1, OK7.2 (C)
unnamed: LED7.C, R52.2
unnamed: OK8.1 (A), R55.2
unnamed: JP17.1, OK8.2 (C)
unnamed: LED8.C, R54.2
SW0: S1.1, S1.2, U$5.2 (PF0/OSC_IN)
SW1: S2.1, S2.2, U$5.3 (PF1/OSC_OUT)
VCOM: C3.1, DC1.3 (-VOUT), JP10.2, JP13.2, JP14.2, JP15.2, JP16.2, JP17.2, JP18.2, JP19.2
VIN: C3.2, L2.2, R3.1, R33.1, R35.1, R37.1, R49.1, R51.1, R53.1, R55.1

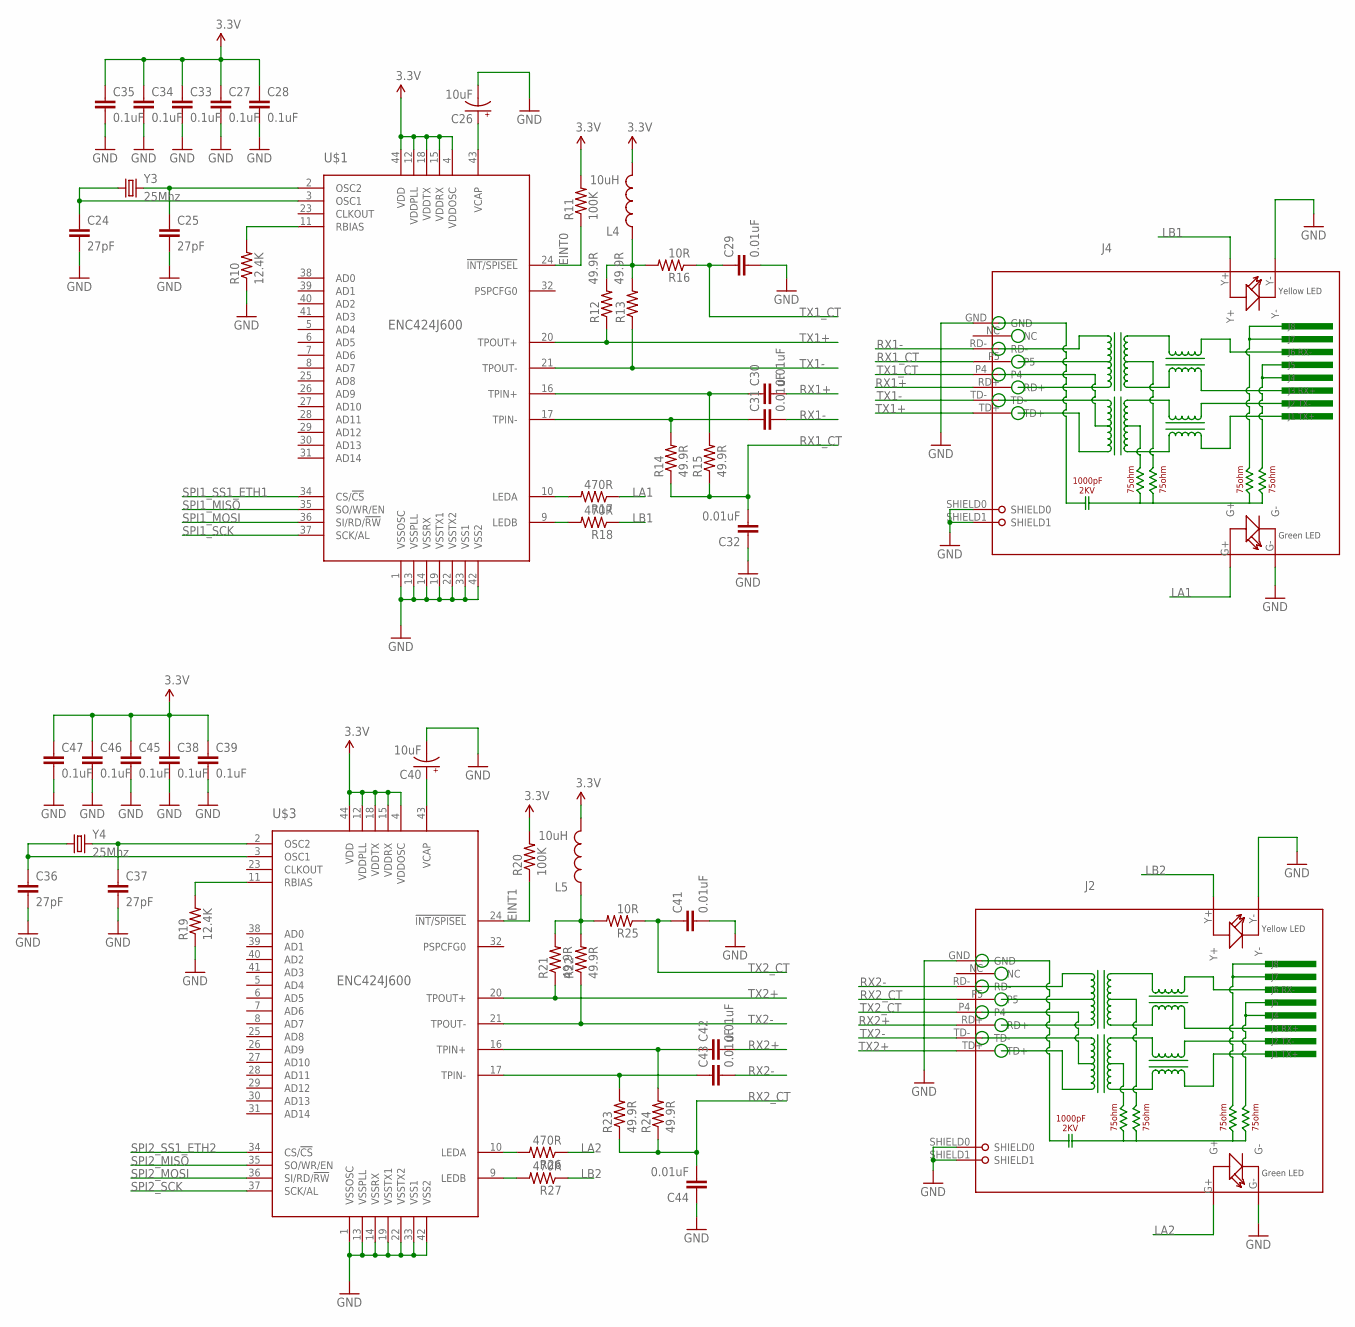
[picture p12: schematic SniperBoard.sch, sheet 4]

Parts:
C24, C25, C36, C37: 27pF; 0805
C26, C40: 10uF; EIA3528-KIT
C27, C28, C33, C34, C35, C38, C39, C45, C46, C47: 0.1uF; 0805
C29, C30, C31, C32, C41, C42, C43, C44: 0.01uF; 0805
J2, J4: RJ45-HR911105A-HR911105A; RJMG1BD3B8K1ANR
L4, L5: 10uH; 0805
R10, R19: 12.4K; 0805
R11, R20: 100K; 0805
R12, R13, R14, R15, R21, R22, R23, R24: 49.9R; 0805
R16, R25: 10R; 0805
R17, R18, R26, R27: 470R; 0805
U$1, U$3: ENC424J600; TQFP-44
Y3, Y4: 25Mhz; CRYSTAL-SMD-10.5X4.8-2PIN

Connections:
3.3V: C27.1, C28.1, C33.1, C34.1, C35.1, C38.1, C39.1, C45.1, C46.1, C47.1, L4.2, L5.2, R11.2, R20.2, U$1.4 (VDDOSC), U$1.12 (VDDPLL), U$1.15 (VDDRX), U$1.18 (VDDTX), U$1.44 (VDD), U$3.4 (VDDOSC), U$3.12 (VDDPLL), U$3.15 (VDDRX), U$3.18 (VDDTX), U$3.44 (VDD); also elsewhere on the board
EINT0: R11.1, U$1.24 (!INT/SPISEL); also elsewhere on the board
EINT1: R20.1, U$3.24 (!INT/SPISEL); also elsewhere on the board
GND: C24.2, C25.2, C26.C (-), C27.2, C28.2, C29.2, C32.1, C33.2, C34.2, C35.2, C36.2, C37.2, C38.2, C39.2, C40.C (-), C41.2, C44.1, C45.2, C46.2, C47.2, J2.G-, J2.GND, J2.SHIELD0, J2.SHIELD1, J2.Y-, J4.G-, J4.GND, J4.SHIELD0, J4.SHIELD1, J4.Y-, R10.1, R19.1, U$1.1 (VSSOSC), U$1.13 (VSSPLL), U$1.14 (VSSRX), U$1.19 (VSSTX1), U$1.22 (VSSTX2), U$1.33 (VSS1), U$1.42 (VSS2), U$3.1 (VSSOSC), U$3.13 (VSSPLL), U$3.14 (VSSRX), U$3.19 (VSSTX1), U$3.22 (VSSTX2), U$3.33 (VSS1), U$3.42 (VSS2); also elsewhere on the board
LA1: J4.G+, R17.1
LA2: J2.G+, R26.1
LB1: J4.Y+, R18.1
LB2: J2.Y+, R27.1
unnamed: C24.1, U$1.3 (OSC1), Y3.P$1 (1)
unnamed: C40.A (+), U$3.43 (VCAP)
unnamed: C37.1, U$3.2 (OSC2), Y4.P$2 (2)
unnamed: C30.1, R15.2, U$1.16 (TPIN+)
unnamed: C26.A (+), U$1.43 (VCAP)
unnamed: C31.1, R14.2, U$1.17 (TPIN-)
unnamed: R19.2, U$3.11 (RBIAS)
unnamed: C25.1, U$1.2 (OSC2), Y3.P$2 (2)
unnamed: R10.2, U$1.11 (RBIAS)
unnamed: R17.2, U$1.10 (LEDA)
unnamed: R18.2, U$1.9 (LEDB)
unnamed: L4.1, R12.2, R13.2, R16.2
unnamed: C36.1, U$3.3 (OSC1), Y4.P$1 (1)
unnamed: C42.1, R24.2, U$3.16 (TPIN+)
unnamed: C43.1, R23.2, U$3.17 (TPIN-)
unnamed: L5.1, R21.2, R22.2, R25.2
unnamed: R26.2, U$3.10 (LEDA)
unnamed: R27.2, U$3.9 (LEDB)
RX1+: C30.2, J4.RD+
RX1-: C31.2, J4.RD-
RX1_CT: C32.2, J4.P5, R14.1, R15.1
RX2+: C42.2, J2.RD+
RX2-: C43.2, J2.RD-
RX2_CT: C44.2, J2.P5, R23.1, R24.1
SPI1_MISO: U$1.35 (SO/WR/EN); also elsewhere on the board
SPI1_MOSI: U$1.36 (SI/RD/!RW); also elsewhere on the board
SPI1_SCK: U$1.37 (SCK/AL); also elsewhere on the board
SPI1_SS1_ETH1: U$1.34 (CS/!CS); also elsewhere on the board
SPI2_MISO: U$3.35 (SO/WR/EN); also elsewhere on the board
SPI2_MOSI: U$3.36 (SI/RD/!RW); also elsewhere on the board
SPI2_SCK: U$3.37 (SCK/AL); also elsewhere on the board
SPI2_SS1_ETH2: U$3.34 (CS/!CS); also elsewhere on the board
TX1+: J4.TD+, R12.1, U$1.20 (TPOUT+)
TX1-: J4.TD-, R13.1, U$1.21 (TPOUT-)
TX1_CT: C29.1, J4.P4, R16.1
TX2+: J2.TD+, R21.1, U$3.20 (TPOUT+)
TX2-: J2.TD-, R22.1, U$3.21 (TPOUT-)
TX2_CT: C41.1, J2.P4, R25.1

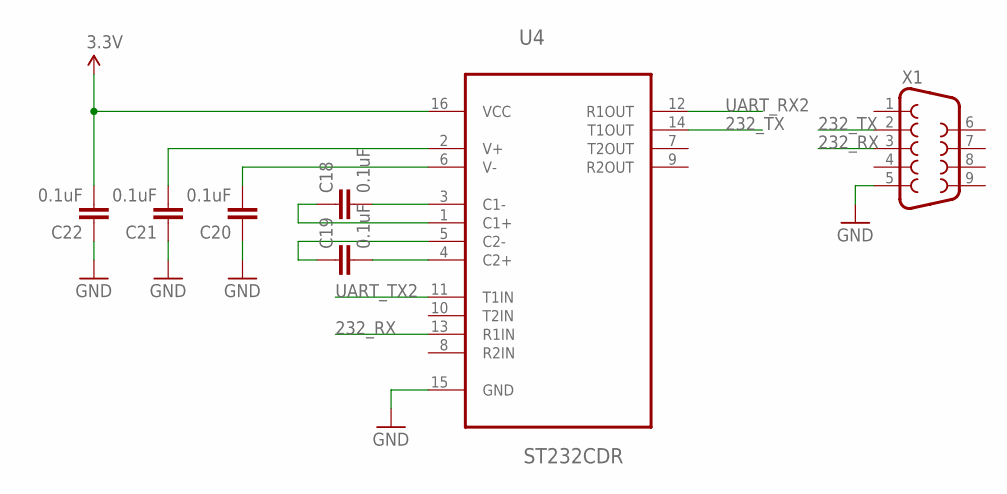
[picture p13: schematic SniperBoard.sch, sheet 5]

Parts:
C18, C19, C20, C21, C22: 0.1uF; 0805
U4: ST232CDR; SOIC127P600X175-16N
X1: DB9FEMALE; DB9

Connections:
3.3V: C22.2, U4.16 (VCC); also elsewhere on the board
232_RX: U4.13 (R1IN), X1.3
232_TX: U4.14 (T1OUT), X1.2
GND: C20.1, C21.1, C22.1, U4.15 (GND), X1.5; also elsewhere on the board
unnamed: C21.2, U4.2 (V+)
unnamed: C20.2, U4.6 (V-)
unnamed: C18.2, U4.3 (C1-)
unnamed: C18.1, U4.1 (C1+)
unnamed: C19.1, U4.5 (C2-)
unnamed: C19.2, U4.4 (C2+)
UART_RX2: U4.12 (R1OUT); also elsewhere on the board
UART_TX2: U4.11 (T1IN); also elsewhere on the board

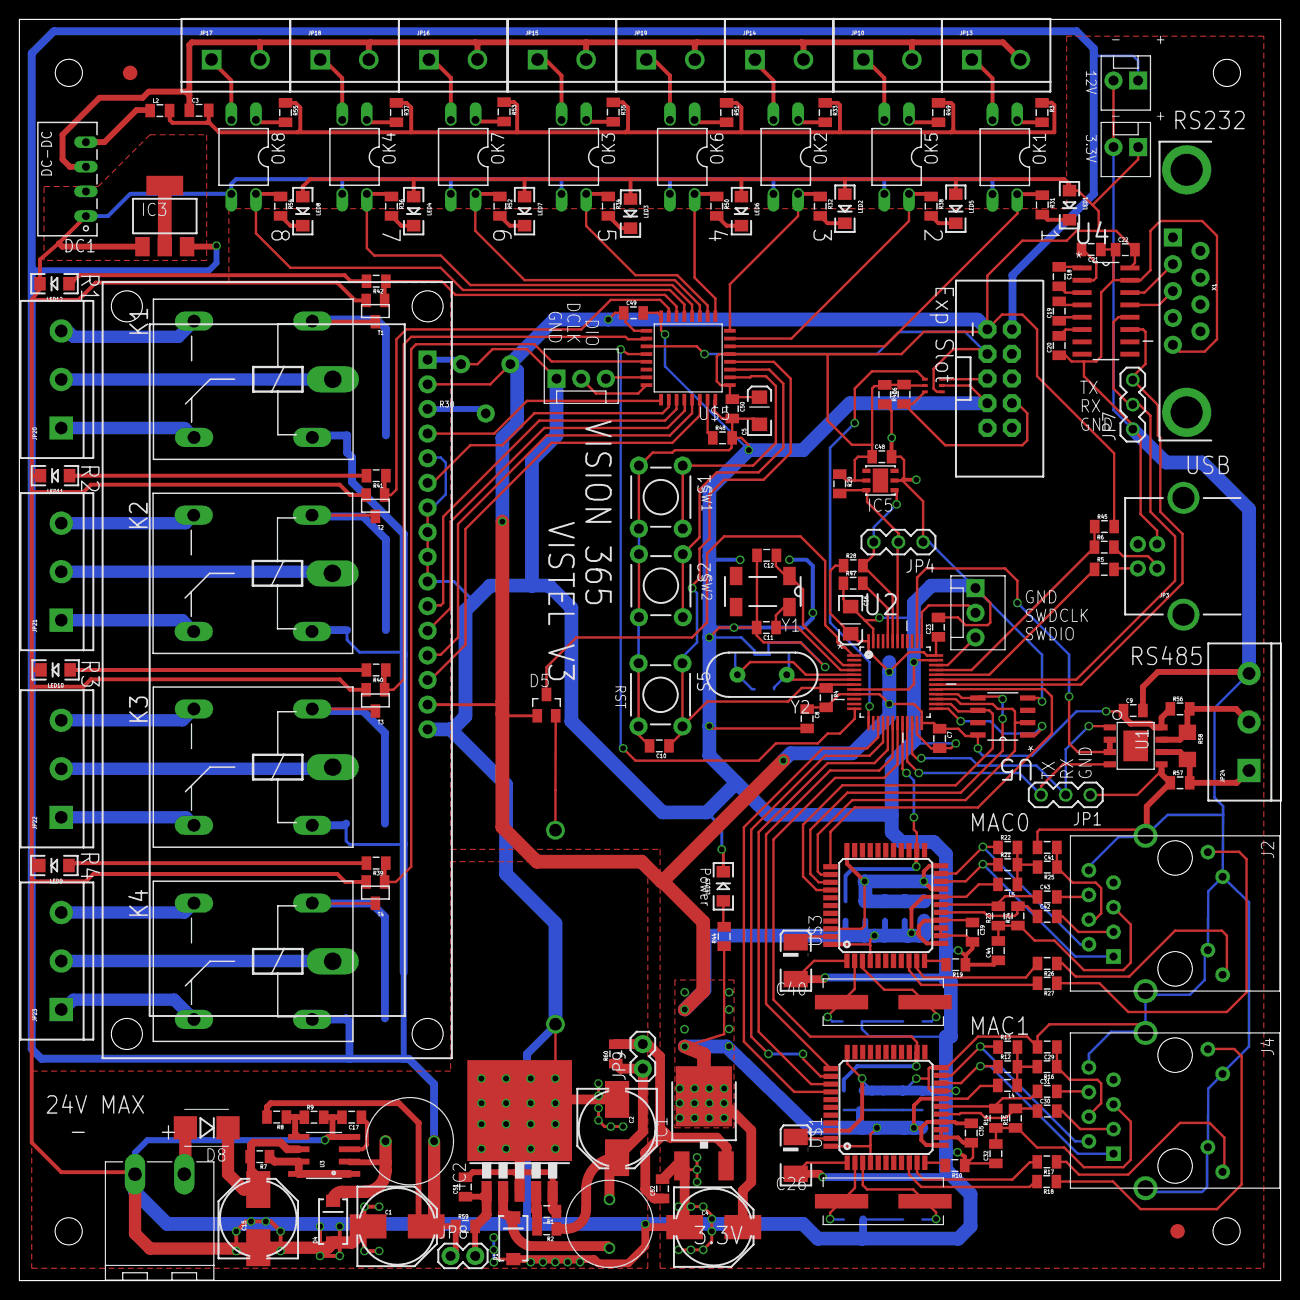
[picture p14: board SniperBoard.brd from above]

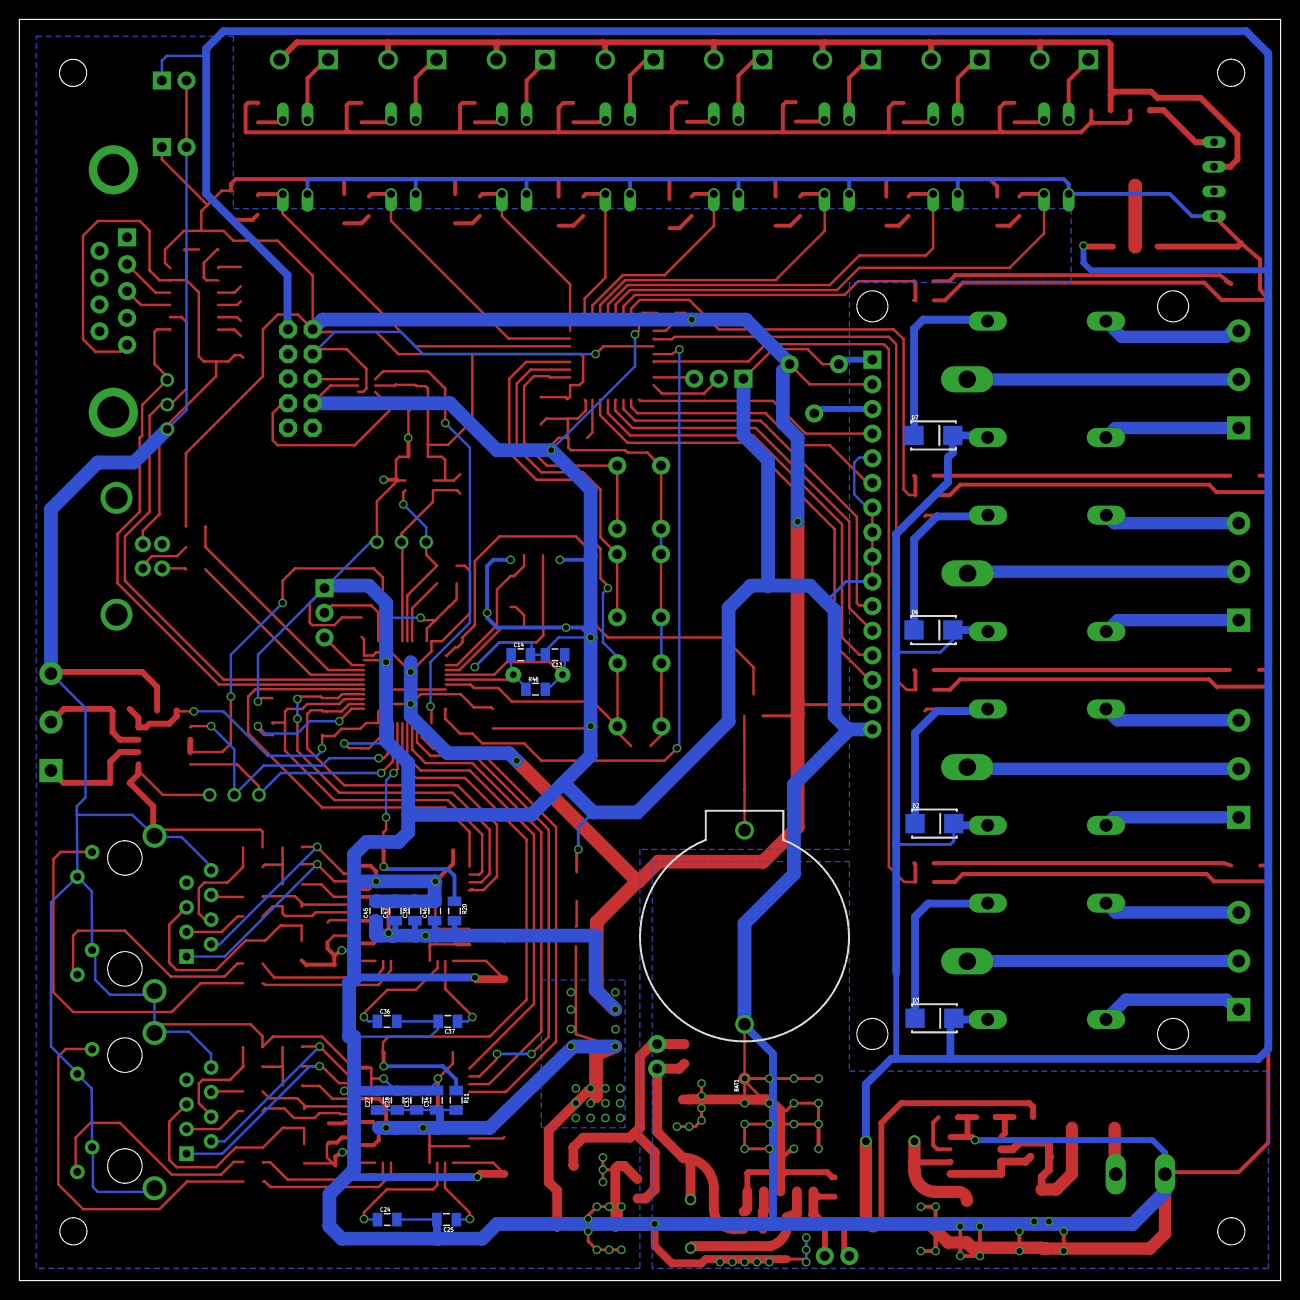
[picture p15: board SniperBoard.brd from below]

Board: 2 copper layers, 130.0 x 130.0 mm, 207 parts (22 on the bottom side), 168 nets.
