aramosfet/Boards/(commit log)

2017-11-15 Vistel Board
    Initial Commit
    [SniperBoard BOM.xlsx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]
2017-11-19 Updated Power suply section
    [VistelV3.brd, VistelV3.sch]
2017-11-26 SniperBoard v1.1 Updated
    [SniperBoard BOM.xls, SniperBoard.brd, SniperBoard.sch]
