aramosfet/Boards/(notices)

Notices in the files:
parts and their libraries:
SparkFun-PowerIC: Licensing: CC v3.0 Share-Alike You are welcome to use this library for commercial purposes.
si70xx-10: (c) 2014 Samuel Lourenço
